jitendraphand/robot-hydraulic/electronics/generated/power_harness.md

# Power budget, harness and CAN load

Generated by `python -m hx gen`.

## Rails

| rail | V | nominal A | peak A | regulator | rating A | margin |
|---|---|---|---|---|---|---|
| LOGIC_5V | 5.0 | 1.16 | 2.05 | buck_5v_6a | 6 | 2.93 |
| BRAIN_5V | 5.1 | 1.80 | 3.50 | buck_5v_6a_pi | 6 | 1.71 |
| VALVE_6V | 6.0 | 1.12 | 6.30 | buck_6v_15a | 15 | 2.38 |
| SERVO_7V4 | 7.4 | 1.40 | 21.50 | buck_7v4_30a | 30 | 1.40 |
| PUMP_BAT | 22.2 | 10.25 | 26.25 | battery | - | nan |

Battery: nominal 263 W, peak 828 W (42 A of 200 A rated); estimated runtime at nominal load **41 min** (80 % depth of discharge).

## Harness

| id | from | to | AWG | length m | connector | fuse A | design A |
|---|---|---|---|---|---|---|---|
| W01 | BATTERY | MAIN_FUSE | 8 | 0.15 | XT90 | - | 40 |
| W02 | MAIN_FUSE | ESTOP_CONTACTOR | 8 | 0.2 | ring M5 | 60 | 40 |
| W03 | ESTOP_CONTACTOR | PDB_ACT | 8 | 0.15 | ring M5 | - | 40 |
| W04 | MAIN_FUSE | PDB_LOGIC | 16 | 0.2 | XT30 | 10 | 4 |
| W05 | PDB_ACT | ESC | 12 | 0.3 | XT60 | 35 | 26 |
| W06 | PDB_ACT | buck_7v4_30a | 14 | 0.15 | XT30 | 15 | 8 |
| W07 | PDB_LOGIC | buck_6v_15a | 16 | 0.15 | XT30 | 7.5 | 3 |
| W08 | PDB_LOGIC | buck_5v_6a | 18 | 0.15 | XT30 | 3 | 1 |
| W09 | PDB_LOGIC | buck_5v_6a_pi | 18 | 0.15 | XT30 | 3 | 1.2 |
| W10 | buck_7v4_30a | LEG_SERVO_L | 16 | 0.6 | XT30 | 10 | 4 |
| W11 | buck_7v4_30a | LEG_SERVO_R | 16 | 0.6 | XT30 | 10 | 4 |
| W12 | buck_7v4_30a | ARM_SERVO_L | 18 | 0.5 | XT30 | 7.5 | 5.5 |
| W13 | buck_7v4_30a | ARM_SERVO_R | 18 | 0.5 | XT30 | 7.5 | 5.5 |
| W14 | buck_6v_15a | LIMB_VALVE_L_LEG | 18 | 0.6 | JST-VH 2p | 5 | 2.4 |
| W15 | buck_6v_15a | LIMB_VALVE_R_LEG | 18 | 0.6 | JST-VH 2p | 5 | 2.4 |
| W16 | buck_6v_15a | LIMB_VALVE_ARMS | 18 | 0.5 | JST-VH 2p | 5 | 1.9 |
| W17 | buck_5v_6a | NODES_5V | 20 | 1.2 | JST-XH 4p (CAN+5V) | 3 | 1.6 |
| W18 | PDB_ACT | DUMP_VALVE | 22 | 0.3 | JST-XH 2p | 1 | 0.25 |
| W19 | ESTOP_BUTTON | CONTACTOR_COIL | 22 | 0.6 | JST-XH 2p | 0.5 | 0.15 |
| W20 | NODE | ENCODER | 26 | 0.6 | JST-GH 6p (shielded) | - | 0.02 |
| W21 | NODE | PRESSURE_SENSOR | 26 | 0.6 | JST-GH 3p | - | 0.01 |
| W22 | NODE | VALVE_SERVO | 22 | 0.5 | Futaba 3p | - | 0.9 |

## CAN bus load

| bus | frames/s | load |
|---|---|---|
| CAN_A | 2540 | 34.3 % |
| CAN_B | 2780 | 37.5 % |

## ERC findings

- none

## Power / harness findings

- none
