jitendraphand/robot-hydraulic/docs/img/sil_ankle_pitch.png

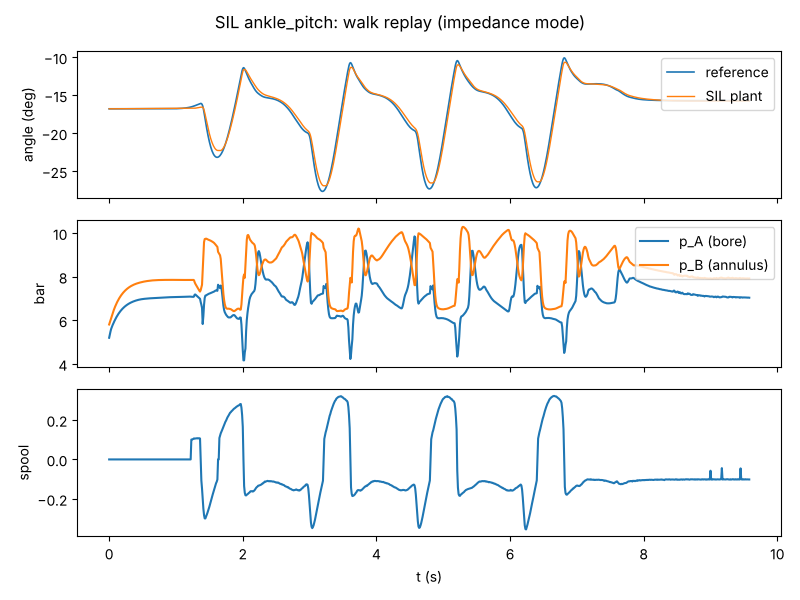
docs/img/sil_ankle_pitch.png
