jitendraphand/robot-hydraulic/docs/img/sil_ankle_roll.png

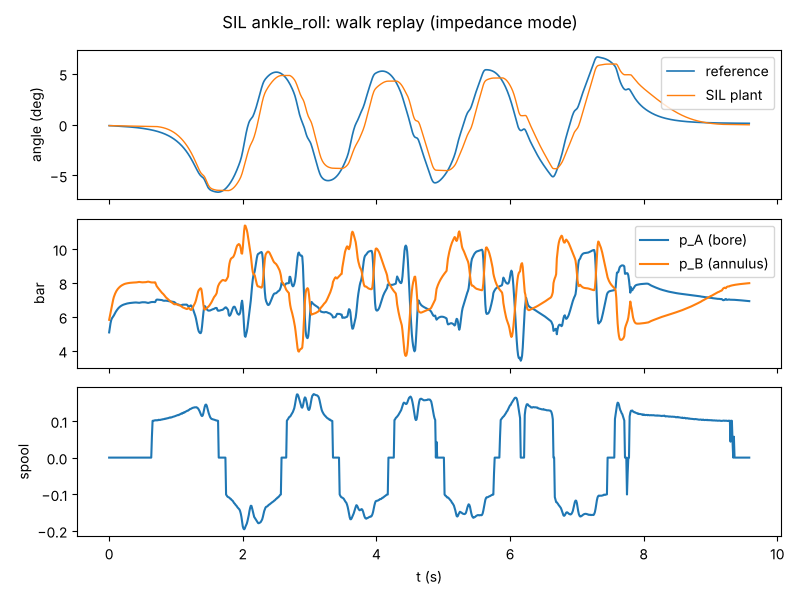
docs/img/sil_ankle_roll.png
