jitendraphand/robot-hydraulic/docs/img/sil_elbow.png

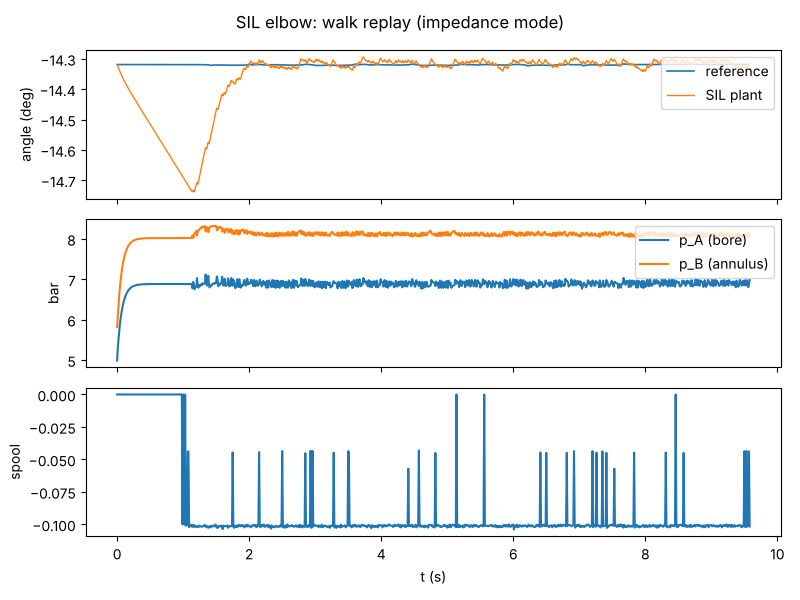
docs/img/sil_elbow.png
