jitendraphand/robot-hydraulic/docs/img/sil_hip_pitch.png

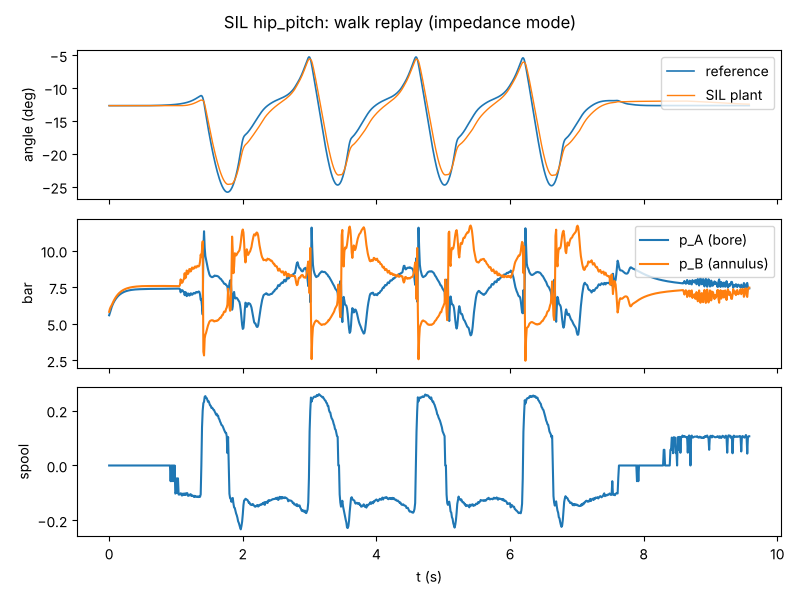
docs/img/sil_hip_pitch.png
