jitendraphand/robot-hydraulic/docs/img/sil_hip_roll.png

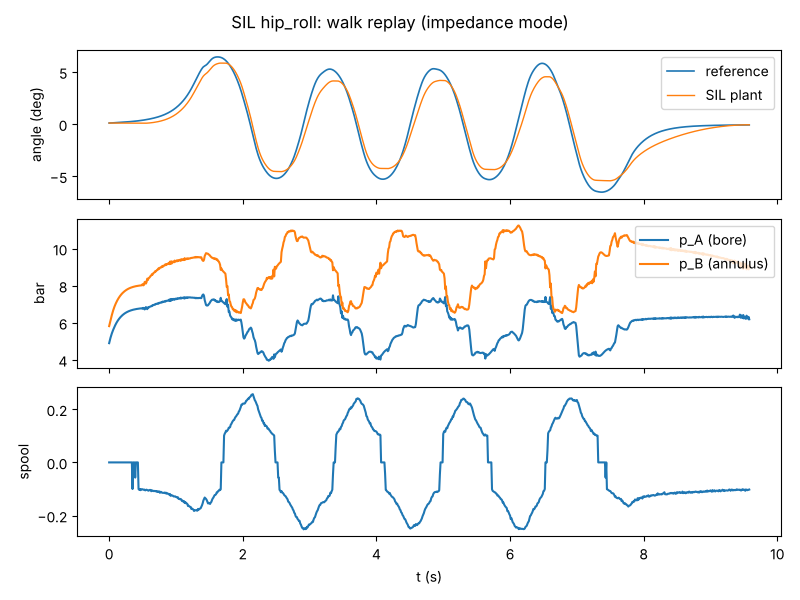
docs/img/sil_hip_roll.png
