jitendraphand/robot-hydraulic/docs/img/sil_shoulder_pitch.png

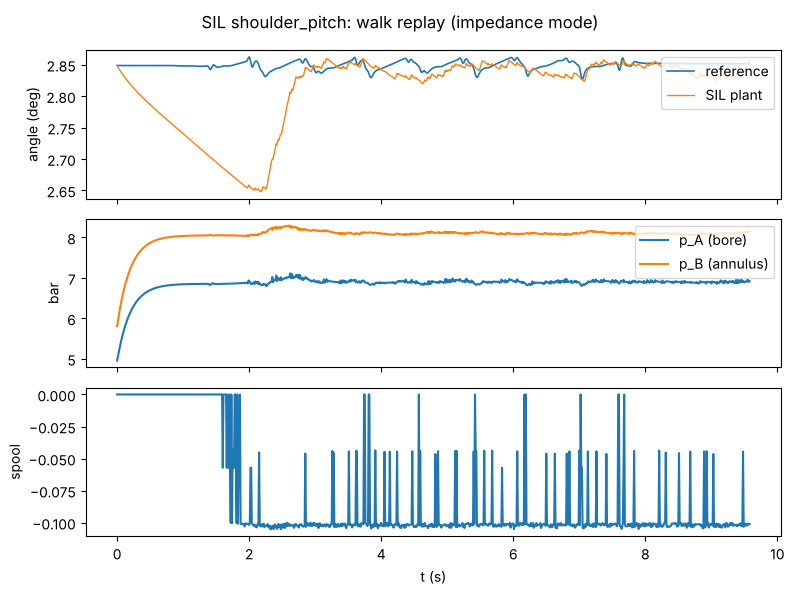
docs/img/sil_shoulder_pitch.png
