jitendraphand/robot-hydraulic/docs/video/gif/stand.gif

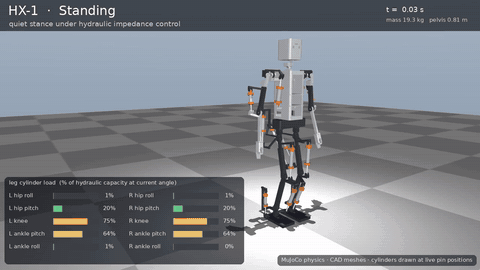
docs/video/gif/stand.gif
