jitendraphand/robot-hydraulic/cad/plates/PETG_plate03.stl

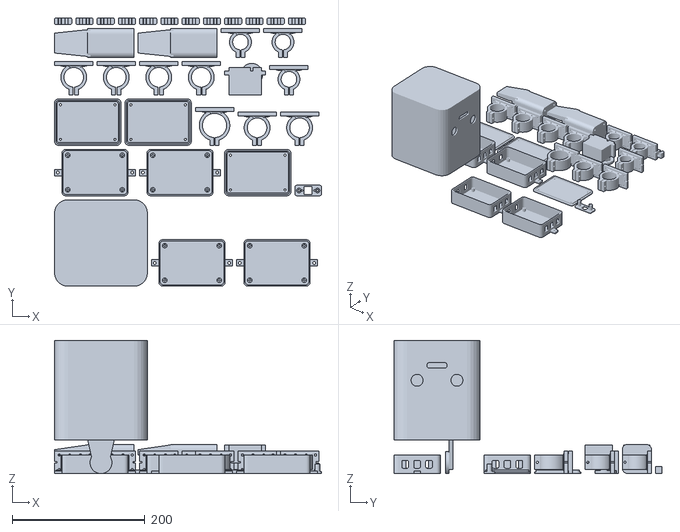
[picture p18: CAD file, 2026-11-11]
cad/plates/PETG_plate03.stl
402.0 x 404.0 x 200.5
