jitendraphand/robot-hydraulic/cad/stl/L_ankle_link.stl

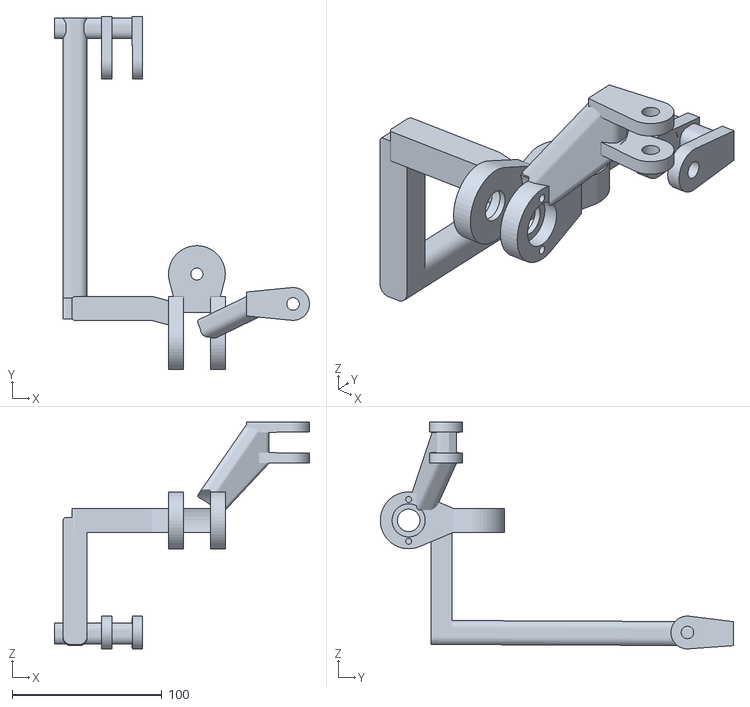
[picture p19: CAD file, 2026-11-11]
cad/stl/L_ankle_link.stl
170.6 x 236.4 x 151.7
