jitendraphand/robot-hydraulic/cad/plates/PA12-CF_plate04.stl

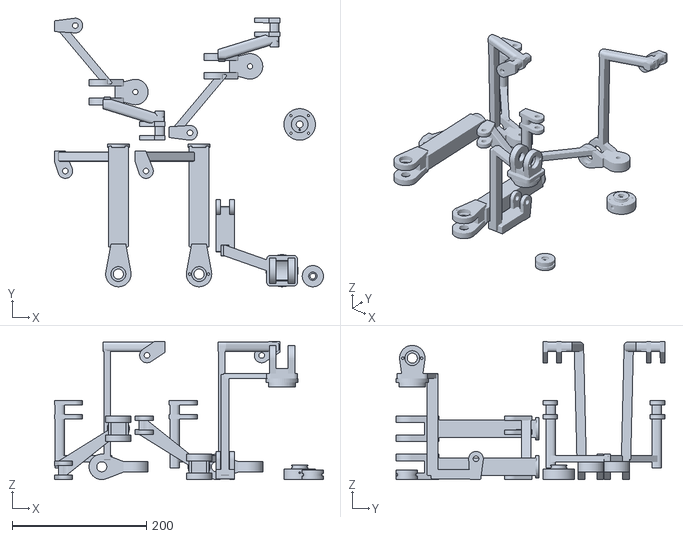
[picture p20: CAD file, 2026-11-11]
cad/plates/PA12-CF_plate04.stl
400.8 x 400.3 x 205.8
