jitendraphand/robot-hydraulic/cad/stl/R_shin.stl

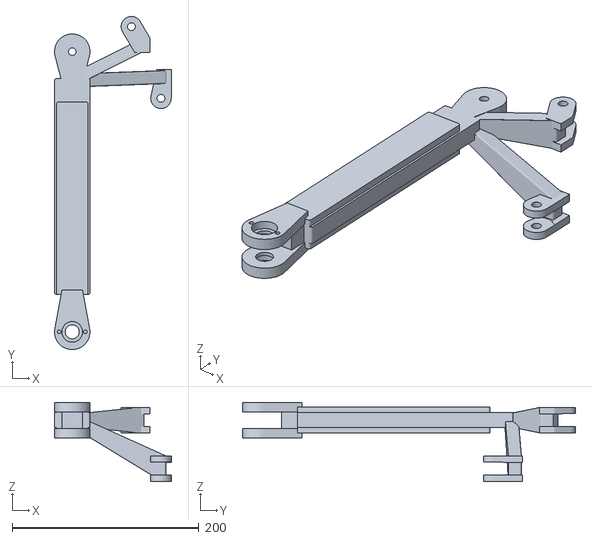
[picture p21: CAD file, 2026-11-11]
cad/stl/R_shin.stl
125.3 x 356.7 x 84.8
