jitendraphand/robot-hydraulic/cad/plates/PA12-CF_plate01.stl

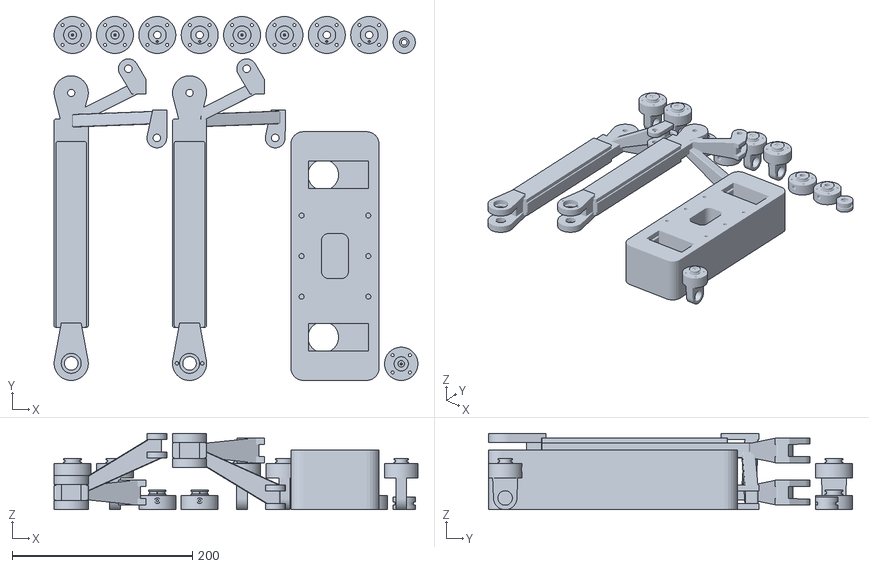
[picture p22: CAD file, 2026-11-11]
cad/plates/PA12-CF_plate01.stl
403.5 x 403.7 x 84.8
