jitendraphand/robot-hydraulic/cad/stl/R_hip_roll_link.stl

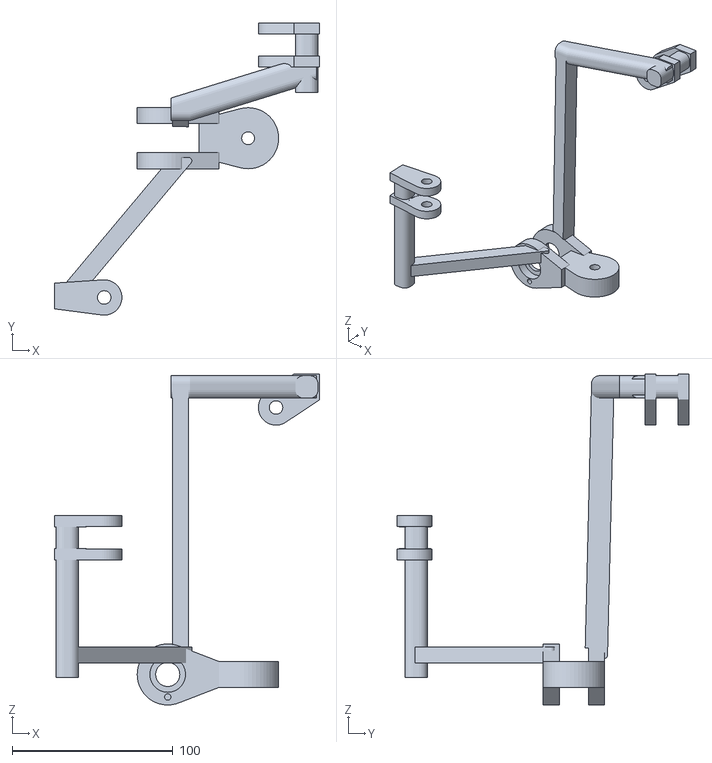
[picture p23: CAD file, 2026-11-11]
cad/stl/R_hip_roll_link.stl
164.9 x 181.8 x 205.8
