jitendraphand/robot-hydraulic/cad/plates/PA12-CF_plate05.stl

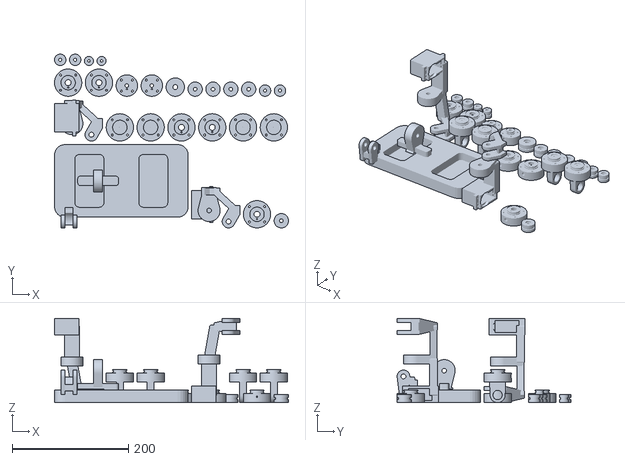
[picture p24: CAD file, 2026-11-11]
cad/plates/PA12-CF_plate05.stl
402.7 x 299.2 x 144.9
