jitendraphand/robot-hydraulic/cad/stl/L_hip_yaw_link.stl

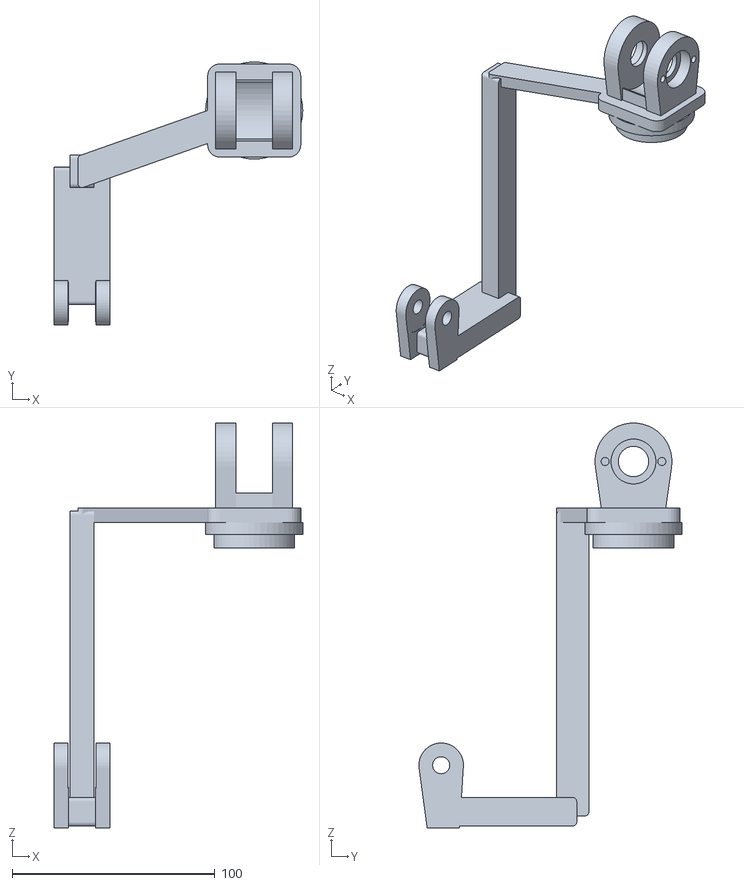
[picture p25: CAD file, 2026-11-11]
cad/stl/L_hip_yaw_link.stl
122.8 x 129.9 x 199.9
