jitendraphand/robot-hydraulic/cad/plates/PA12-CF_plate02.stl

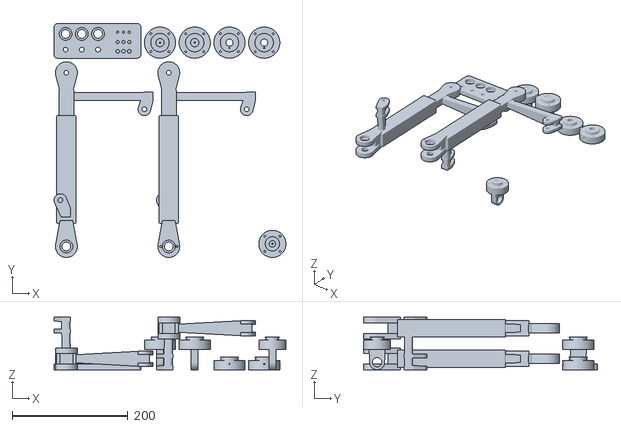
[picture p26: CAD file, 2026-11-11]
cad/plates/PA12-CF_plate02.stl
400.6 x 404.0 x 90.8
