jitendraphand/robot-hydraulic/cad/stl/R_upper_arm.stl

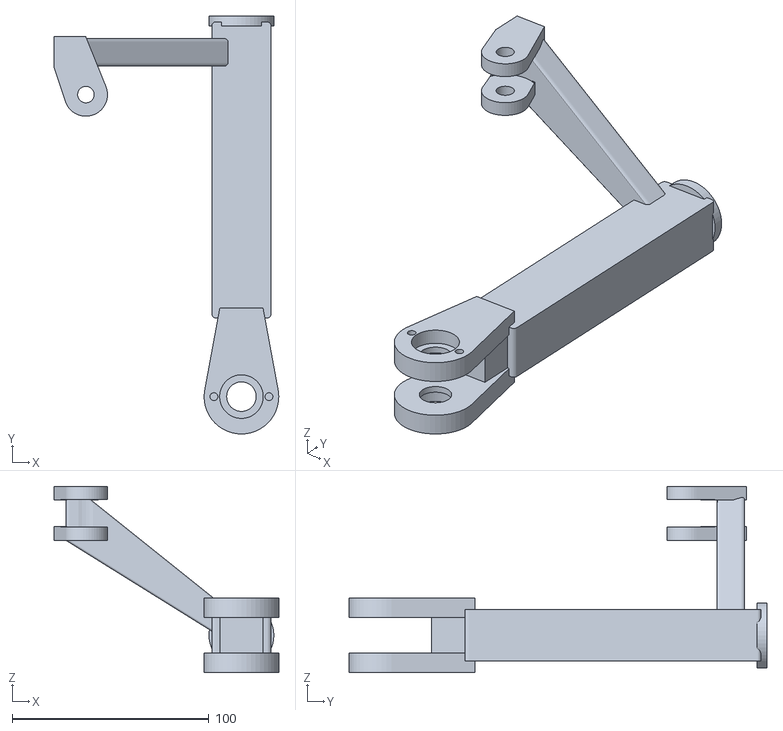
[picture p27: CAD file, 2026-11-11]
cad/stl/R_upper_arm.stl
114.2 x 212.5 x 94.8
