jitendraphand/robot-hydraulic/cad/plates/PA12-CF_plate03.stl

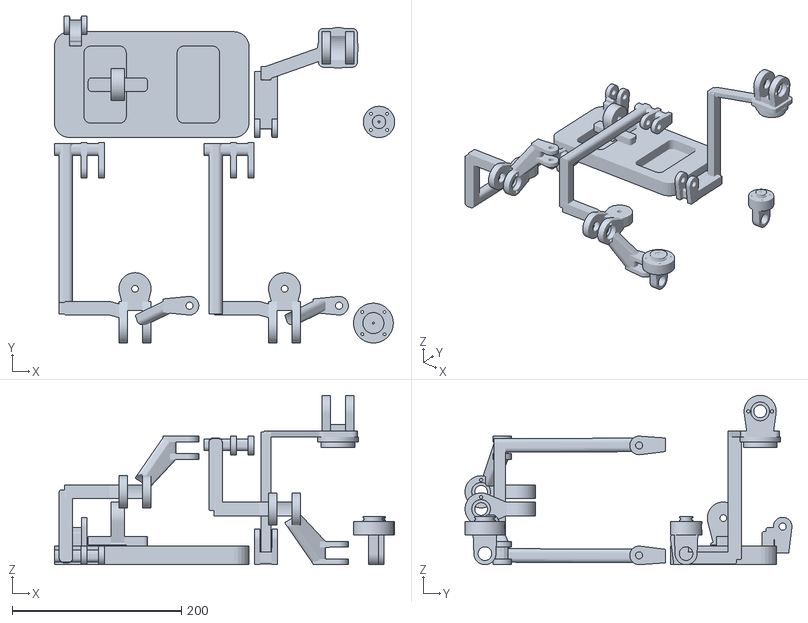
[picture p28: CAD file, 2026-11-11]
cad/plates/PA12-CF_plate03.stl
401.8 x 385.9 x 199.9
