jitendraphand/robot-hydraulic/cad/plates/PETG_plate01.stl

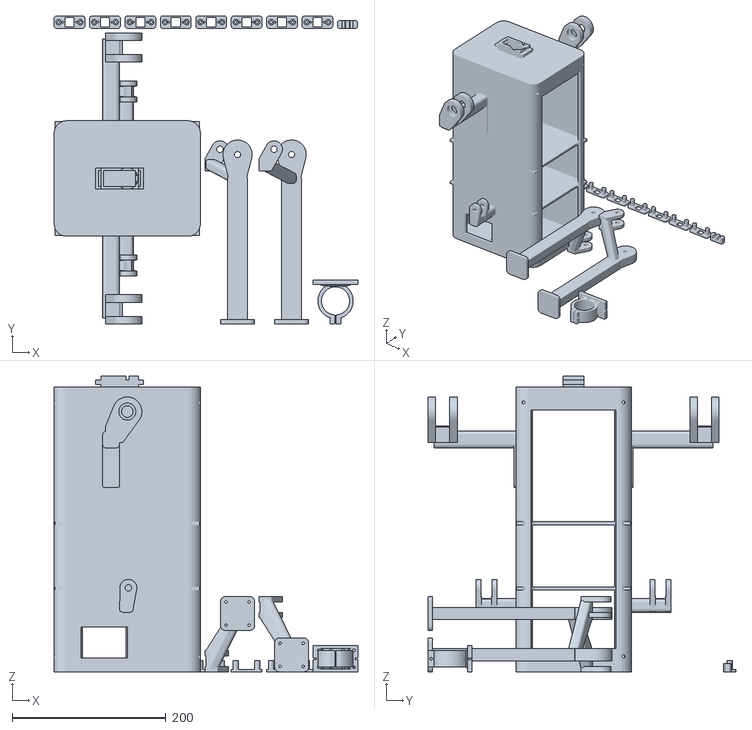
[picture p29: CAD file, 2026-11-11]
cad/plates/PETG_plate01.stl
394.5 x 400.0 x 384.0
