jitendraphand/robot-hydraulic/cad/plates/PETG_plate02.stl

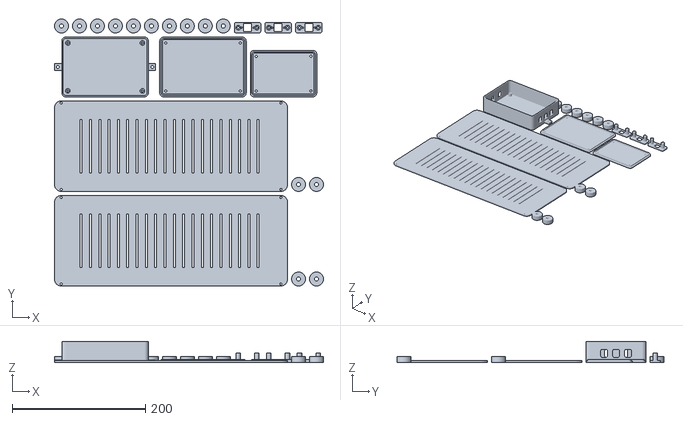
[picture p30: CAD file, 2026-11-11]
cad/plates/PETG_plate02.stl
404.0 x 401.0 x 32.0
