jitendraphand/robot-hydraulic/cad/stl/L_thigh.stl

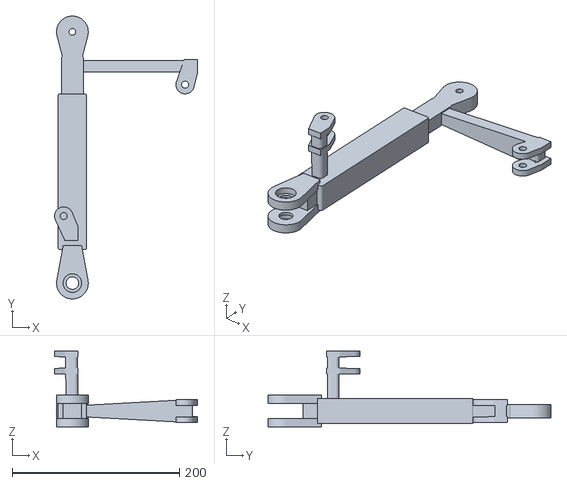
[picture p31: CAD file, 2026-11-11]
cad/stl/L_thigh.stl
170.8 x 338.0 x 90.8
