jitendraphand/robot-hydraulic/cad/plates/PETG_plate04.stl

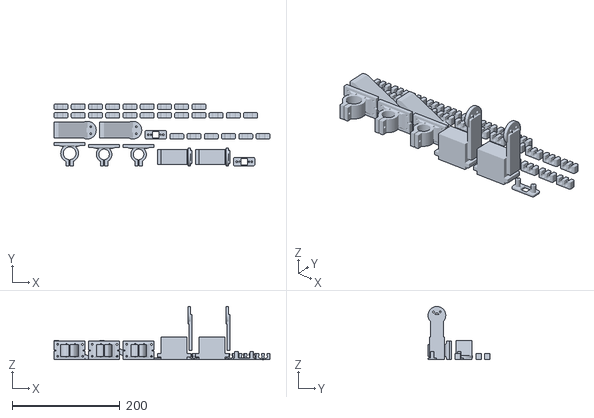
[picture p32: CAD file, 2026-11-11]
cad/plates/PETG_plate04.stl
401.0 x 115.0 x 98.5
