jitendraphand/robot-hydraulic/cad/plates/TPU95A_plate01.stl

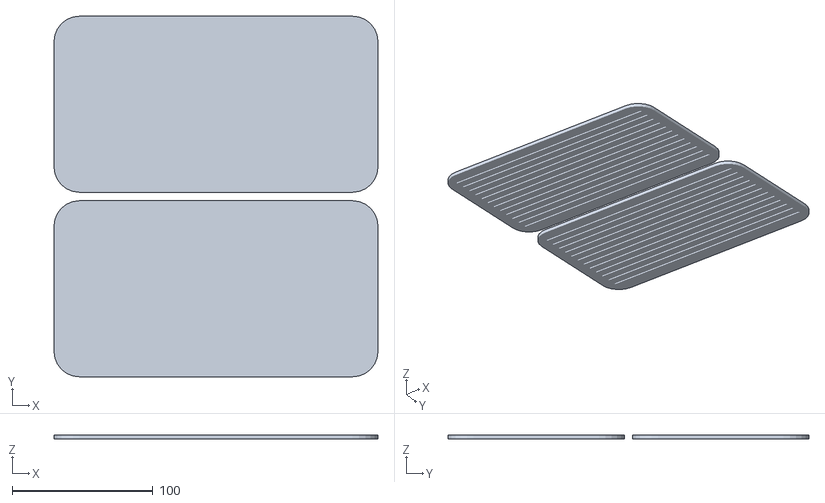
[picture p33: CAD file, 2026-11-11]
cad/plates/TPU95A_plate01.stl
230.0 x 256.0 x 3.00
