jitendraphand/robot-hydraulic/cad/stl/R_forearm.stl

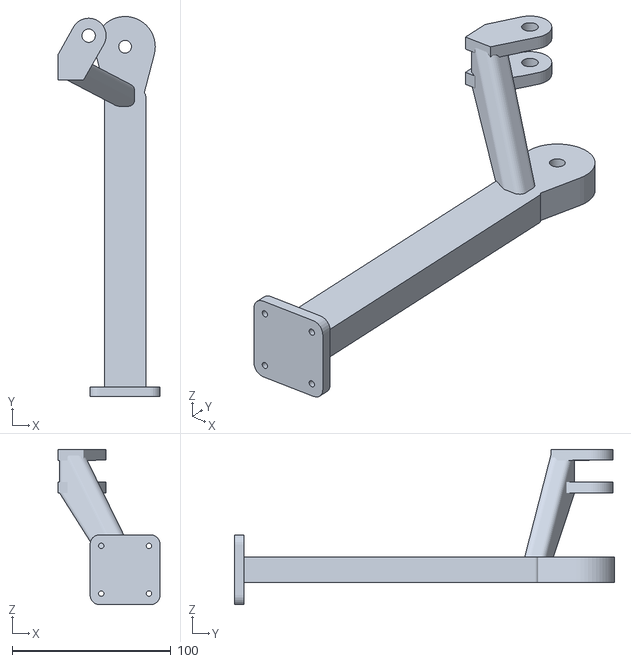
[picture p34: CAD file, 2026-11-11]
cad/stl/R_forearm.stl
64.2 x 239.0 x 97.8
