jitendraphand/robot-hydraulic/cad/stl/R_foot.stl

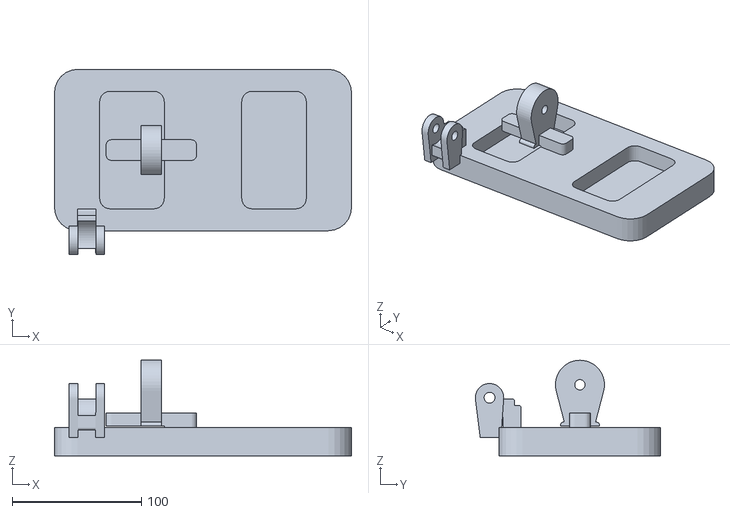
[picture p35: CAD file, 2026-11-11]
cad/stl/R_foot.stl
230.0 x 143.5 x 74.0
