jitendraphand/robot-hydraulic/cad/stl/L_shoulder_link.stl

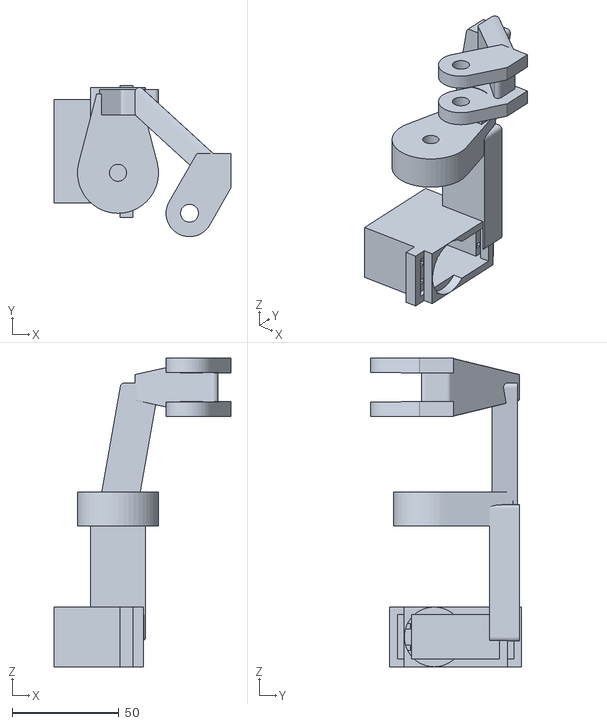
[picture p36: CAD file, 2026-11-11]
cad/stl/L_shoulder_link.stl
83.0 x 71.0 x 144.9
