jitendraphand/robot-hydraulic/cad/stl/cyl_b32s75_rod_cap.stl

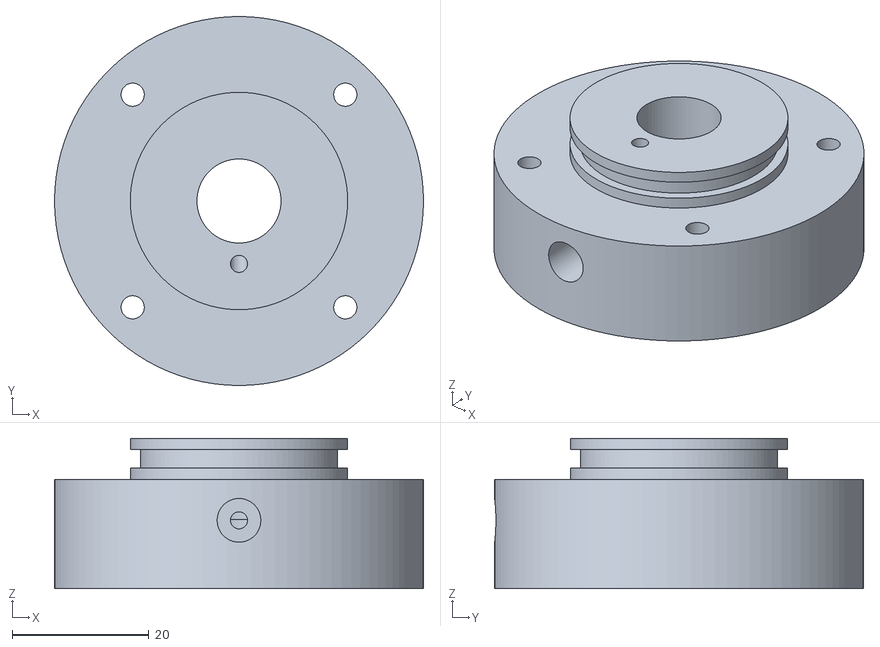
[picture p37: CAD file, 2026-11-11]
cad/stl/cyl_b32s75_rod_cap.stl
54.0 x 54.0 x 22.0
