jitendraphand/robot-hydraulic/cad/stl/foot_pad.stl

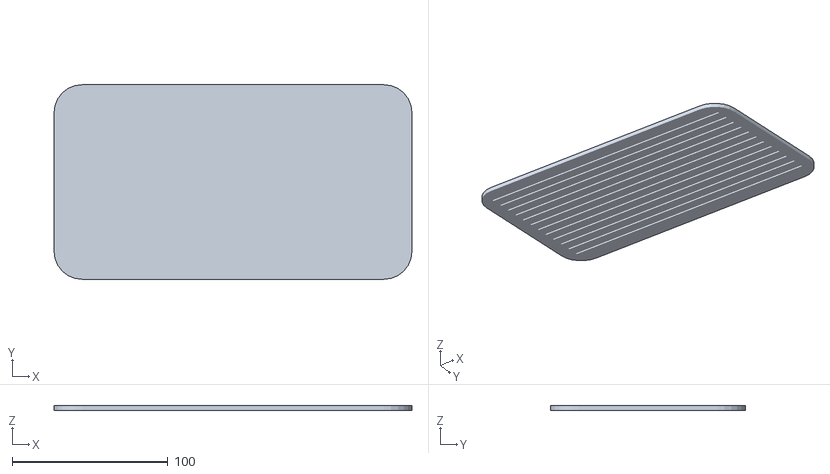
[picture p38: CAD file, 2026-11-11]
cad/stl/foot_pad.stl
230.0 x 125.0 x 3.00
