jitendraphand/robot-hydraulic/cad/stl/cyl_b32s75_blind_cap.stl

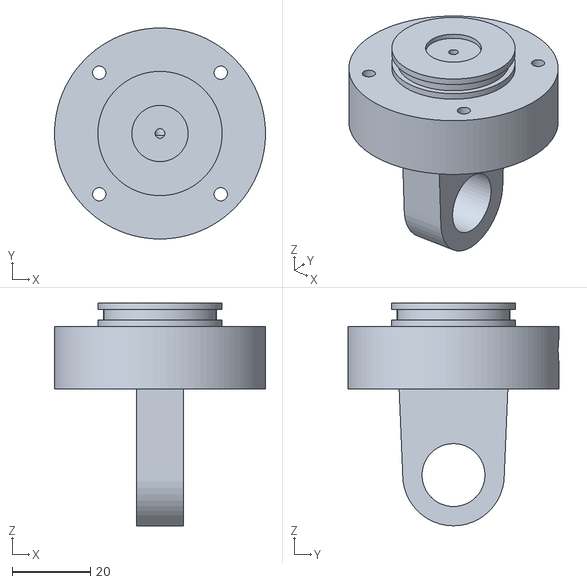
[picture p39: CAD file, 2026-11-11]
cad/stl/cyl_b32s75_blind_cap.stl
54.0 x 54.0 x 57.0
