jitendraphand/robot-hydraulic/cad/stl/cyl_b16s140_blind_cap.stl

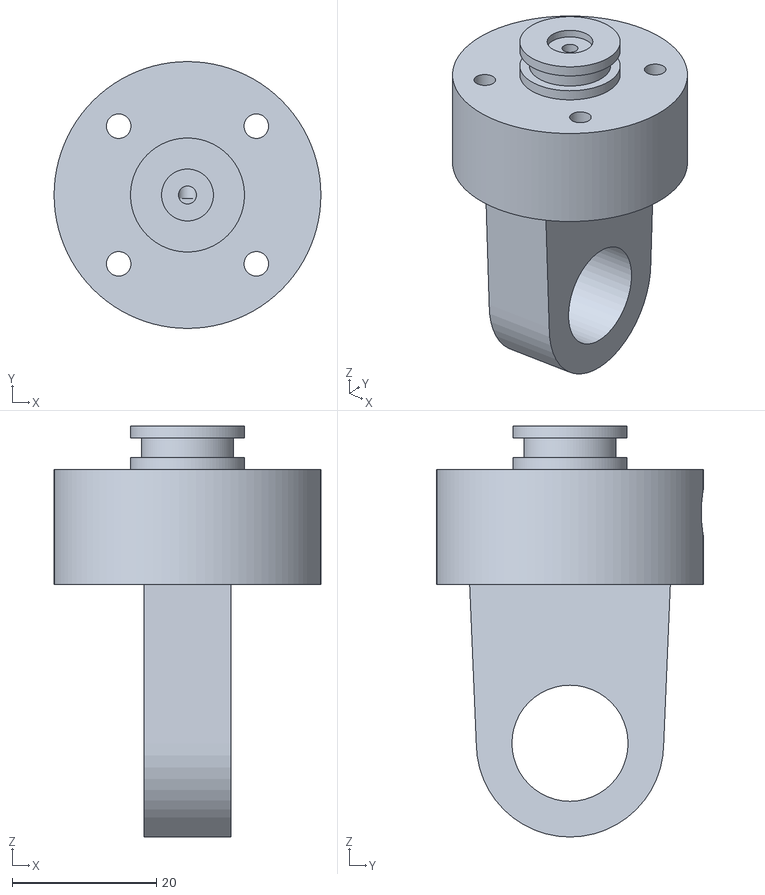
[picture p40: CAD file, 2026-11-11]
cad/stl/cyl_b16s140_blind_cap.stl
37.0 x 37.0 x 57.0
