jitendraphand/robot-hydraulic/cad/stl/cyl_b20s55_piston.stl

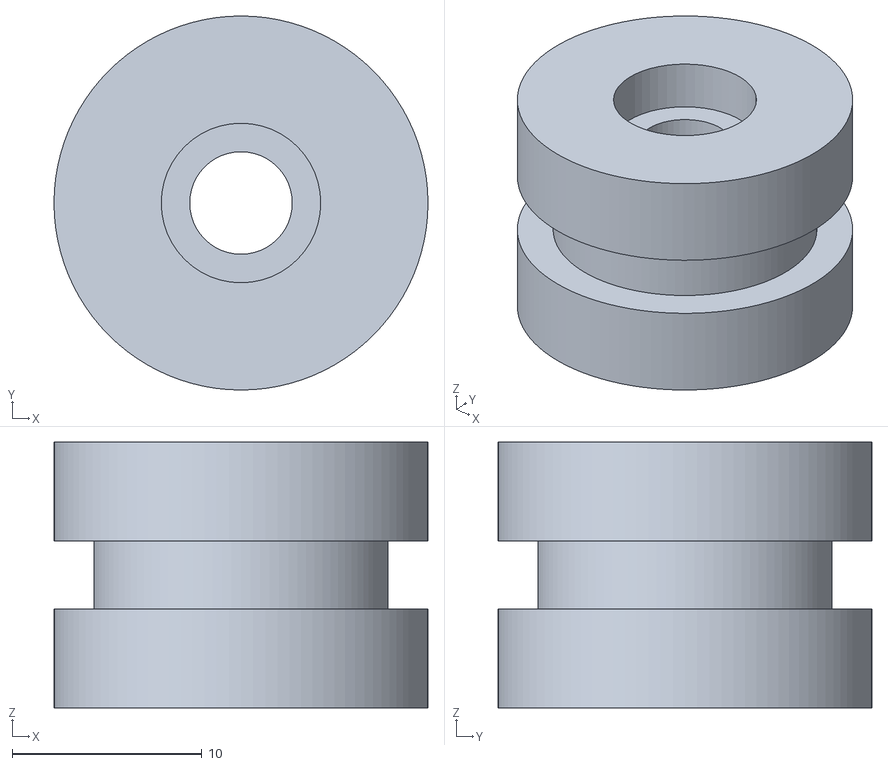
[picture p41: CAD file, 2026-11-11]
cad/stl/cyl_b20s55_piston.stl
19.7 x 19.7 x 14.0
