jitendraphand/robot-hydraulic/cad/stl/R_finger.stl

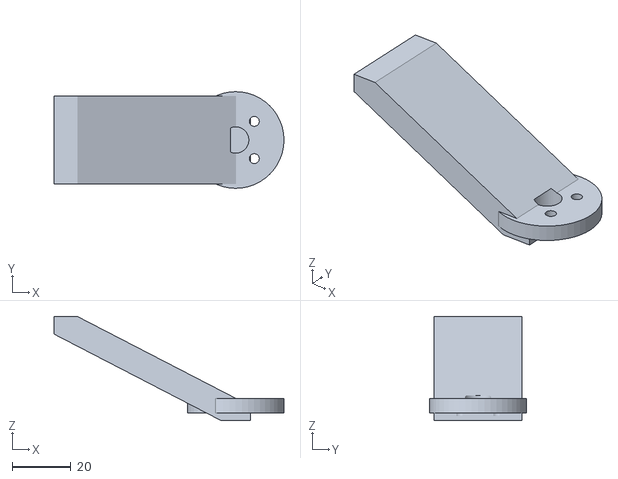
[picture p42: CAD file, 2026-11-11]
cad/stl/R_finger.stl
78.5 x 33.0 x 35.5
