jitendraphand/robot-hydraulic/cad/stl/cyl_b20s55_valve_saddle.stl

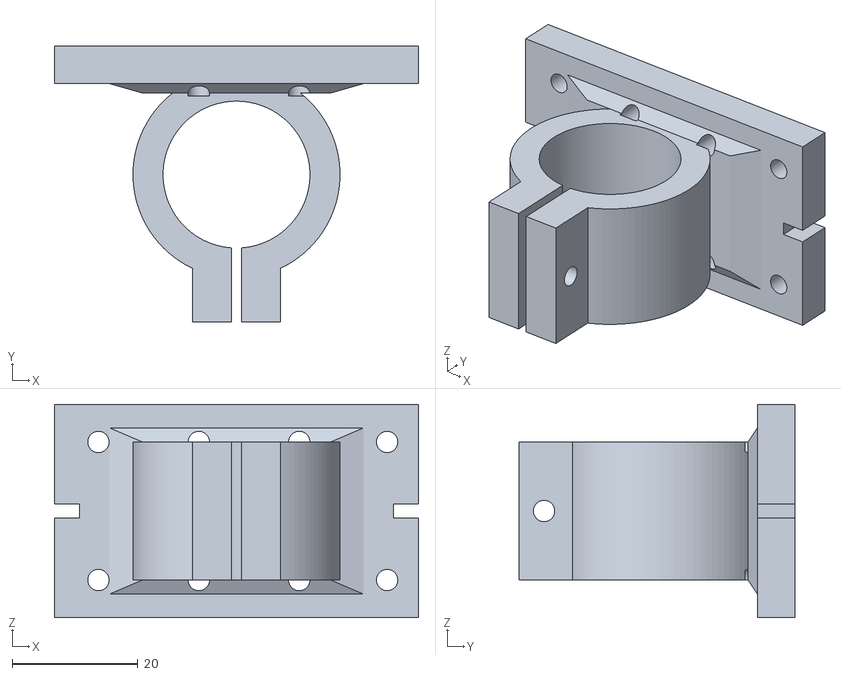
[picture p43: CAD file, 2026-11-11]
cad/stl/cyl_b20s55_valve_saddle.stl
58.0 x 44.0 x 34.0
