jitendraphand/robot-hydraulic/cad/stl/cyl_b32s75_valve_saddle.stl

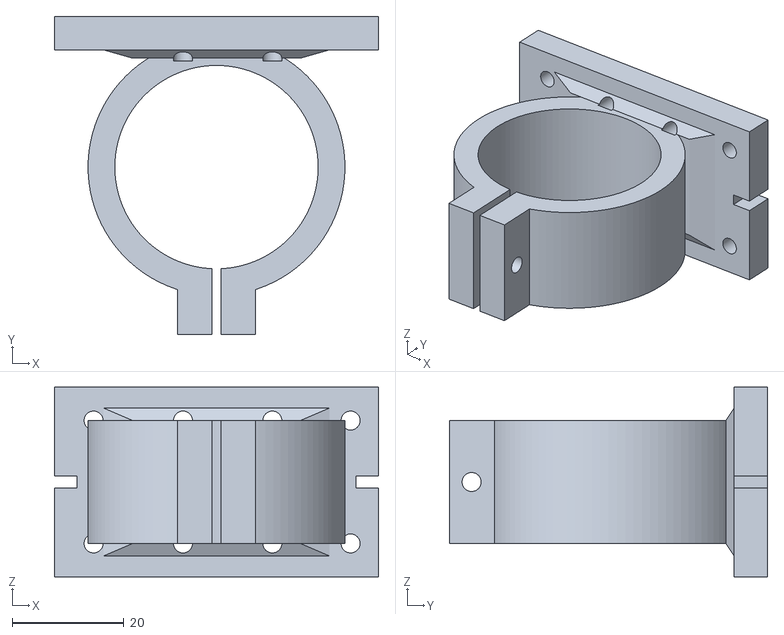
[picture p44: CAD file, 2026-11-11]
cad/stl/cyl_b32s75_valve_saddle.stl
58.0 x 57.0 x 34.0
