jitendraphand/robot-hydraulic/cad/stl/cyl_b25s100_blind_cap.stl

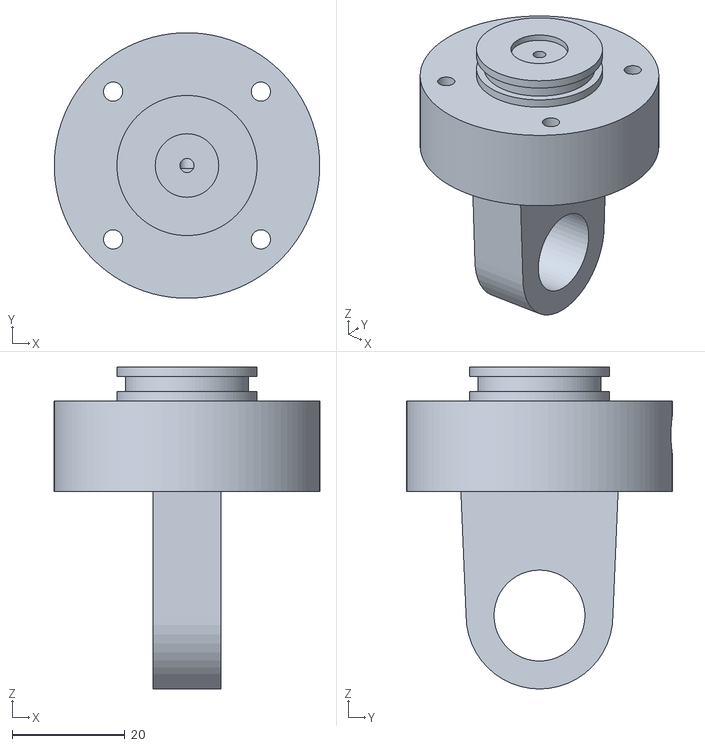
[picture p45: CAD file, 2026-11-11]
cad/stl/cyl_b25s100_blind_cap.stl
47.0 x 47.0 x 57.0
