jitendraphand/robot-hydraulic/cad/stl/R_upper_arm_roll.stl

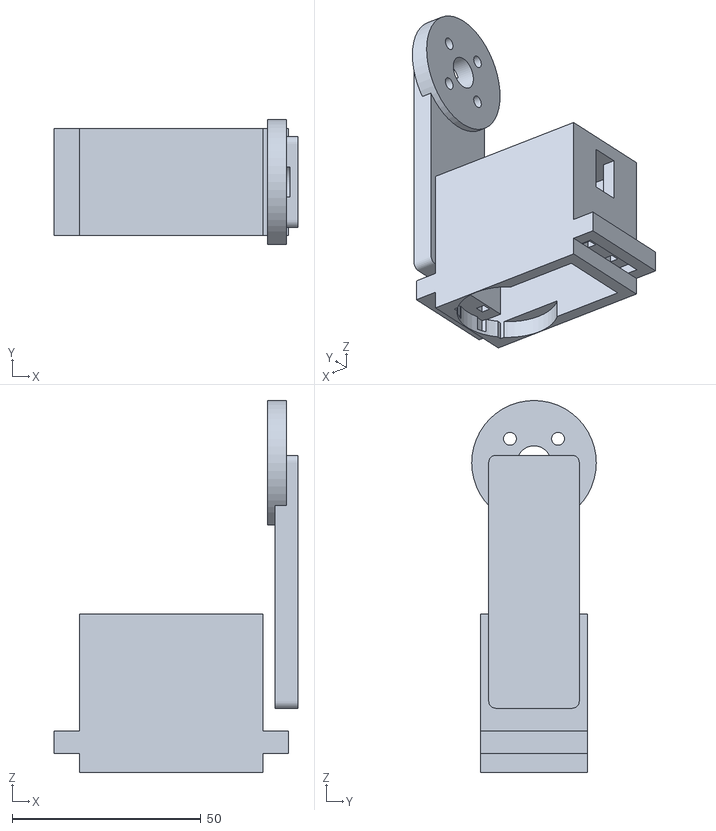
[picture p46: CAD file, 2026-11-11]
cad/stl/R_upper_arm_roll.stl
64.5 x 33.0 x 98.5
