jitendraphand/robot-hydraulic/cad/stl/cyl_b32s75_piston.stl

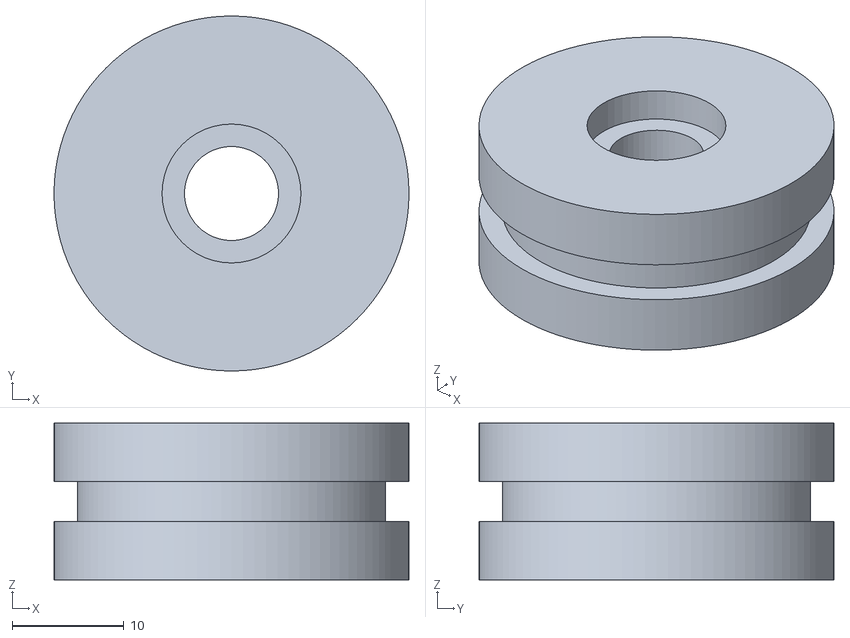
[picture p47: CAD file, 2026-11-11]
cad/stl/cyl_b32s75_piston.stl
31.7 x 31.7 x 14.0
