jitendraphand/robot-hydraulic/cad/stl/hub_lid.stl

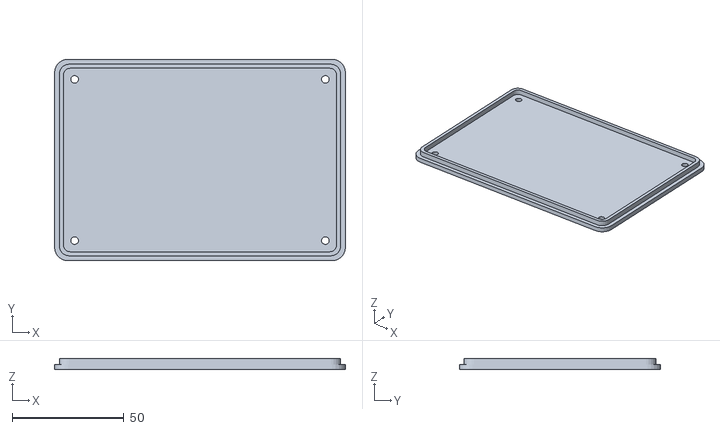
[picture p48: CAD file, 2026-11-11]
cad/stl/hub_lid.stl
130.0 x 90.0 x 5.10
