jitendraphand/robot-hydraulic/cad/stl/cyl_b25s100_piston.stl

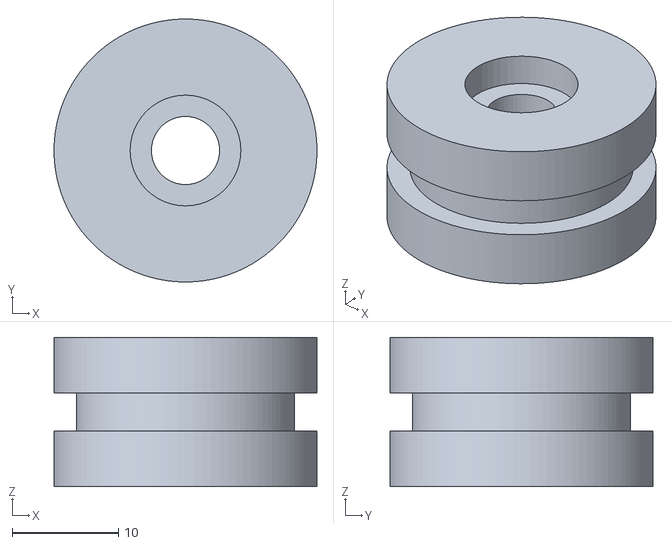
[picture p49: CAD file, 2026-11-11]
cad/stl/cyl_b25s100_piston.stl
24.7 x 24.7 x 14.0
