jitendraphand/robot-hydraulic/cad/stl/cyl_b20s55_rod_cap.stl

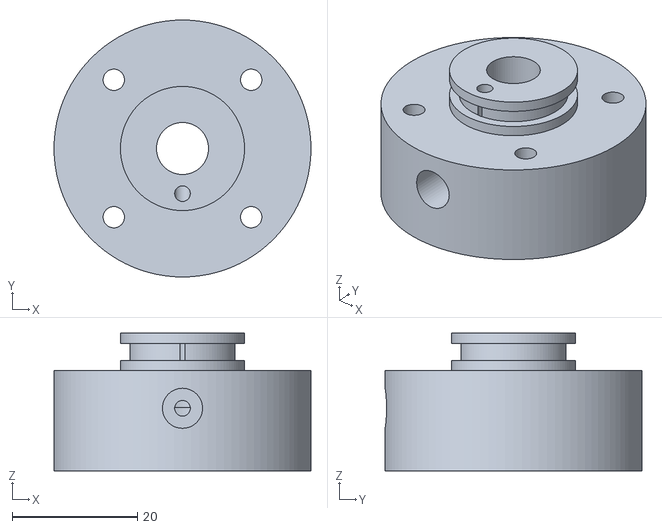
[picture p50: CAD file, 2026-11-11]
cad/stl/cyl_b20s55_rod_cap.stl
41.0 x 41.0 x 22.0
