jitendraphand/robot-hydraulic/cad/stl/limb_node_lid.stl

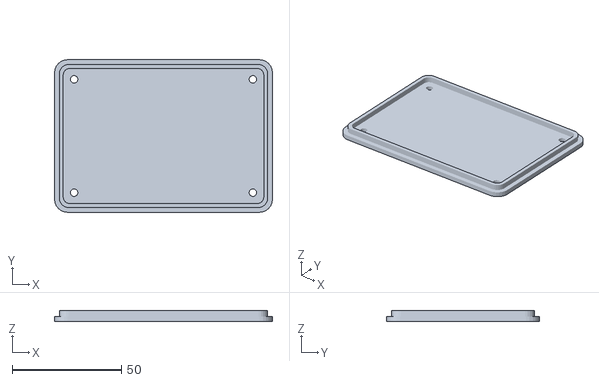
[picture p51: CAD file, 2026-11-11]
cad/stl/limb_node_lid.stl
100.0 x 70.0 x 5.10
