jitendraphand/robot-hydraulic/cad/stl/hose_clip.stl

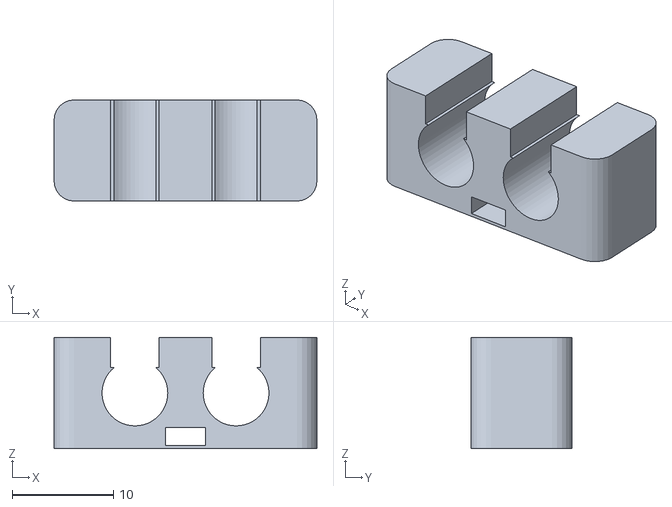
[picture p52: CAD file, 2026-11-11]
cad/stl/hose_clip.stl
26.0 x 10.0 x 11.0
