jitendraphand/robot-hydraulic/cad/stl/cyl_b16s140_piston.stl

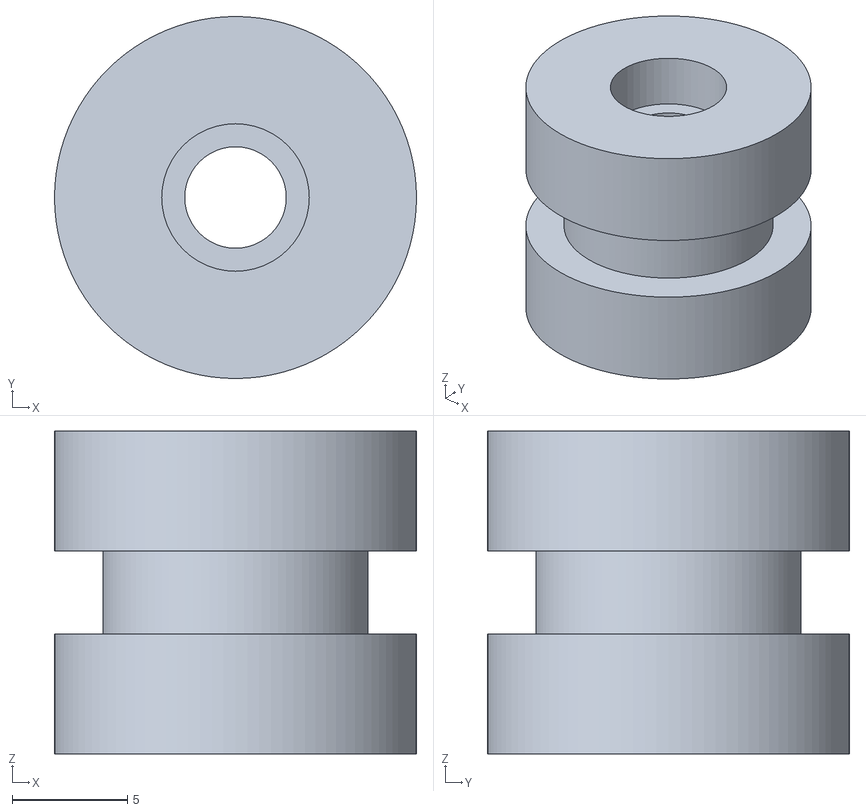
[picture p53: CAD file, 2026-11-11]
cad/stl/cyl_b16s140_piston.stl
15.7 x 15.7 x 14.0
