jitendraphand/robot-hydraulic/cad/stl/encoder_magnet_cap.stl

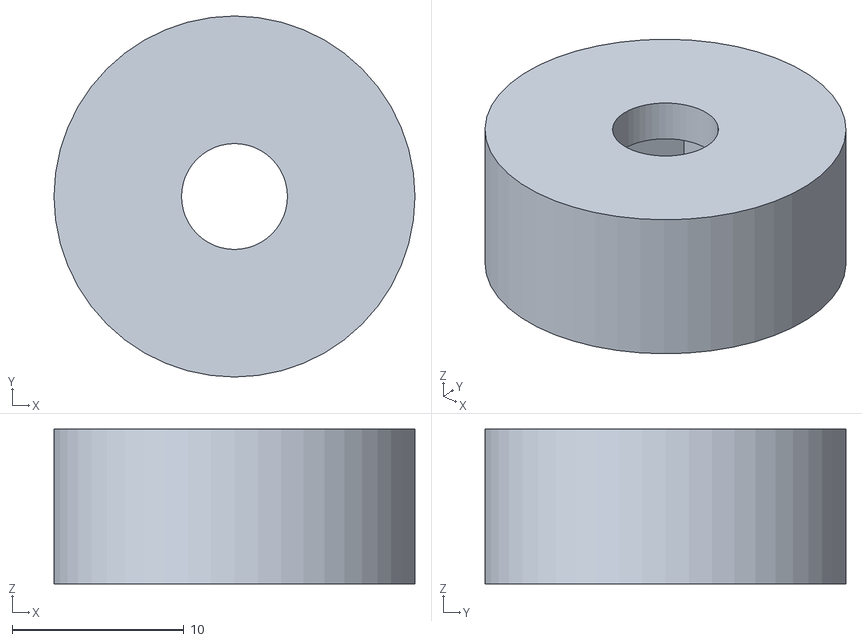
[picture p54: CAD file, 2026-11-11]
cad/stl/encoder_magnet_cap.stl
21.0 x 21.0 x 9.00
