jitendraphand/robot-hydraulic/cad/stl/head.stl

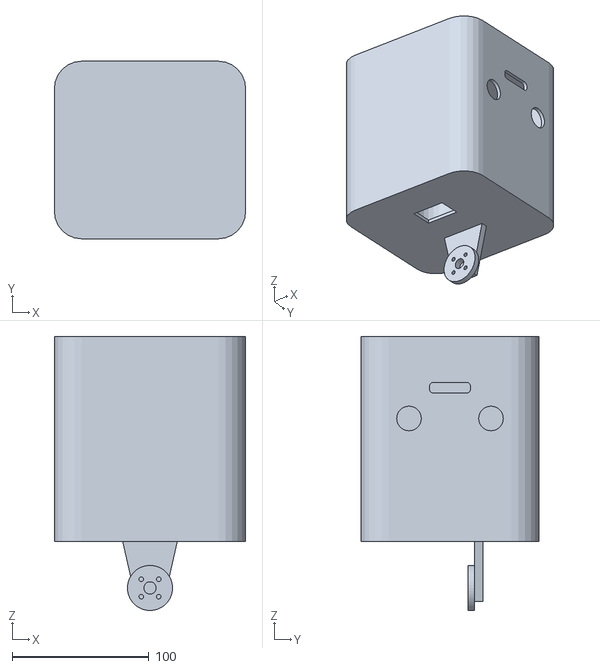
[picture p55: CAD file, 2026-11-11]
cad/stl/head.stl
140.0 x 130.0 x 200.5
