jitendraphand/robot-hydraulic/cad/stl/torso.stl

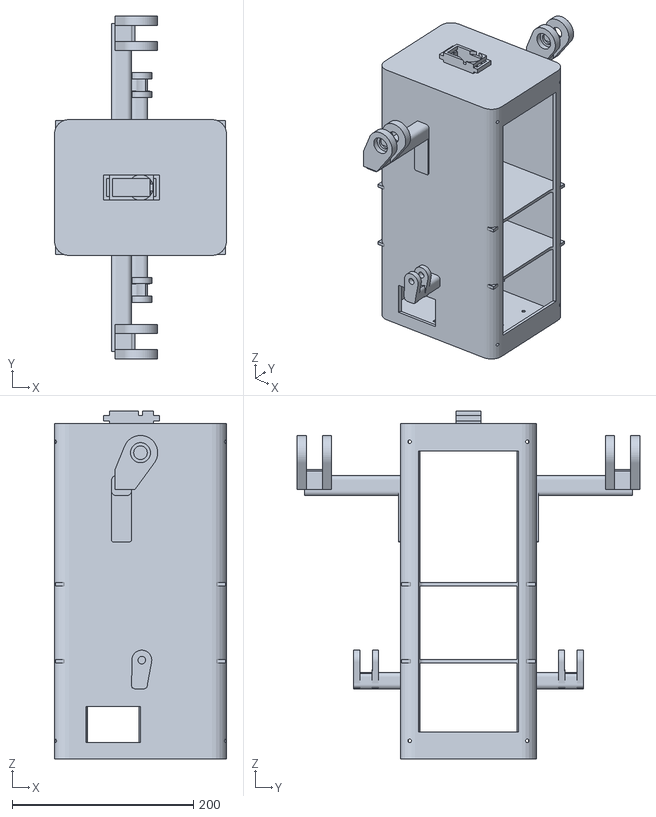
[picture p56: CAD file, 2026-11-11]
cad/stl/torso.stl
190.0 x 378.0 x 384.0
