jitendraphand/robot-hydraulic/cad/stl/cyl_b25s105_rod_cap.stl

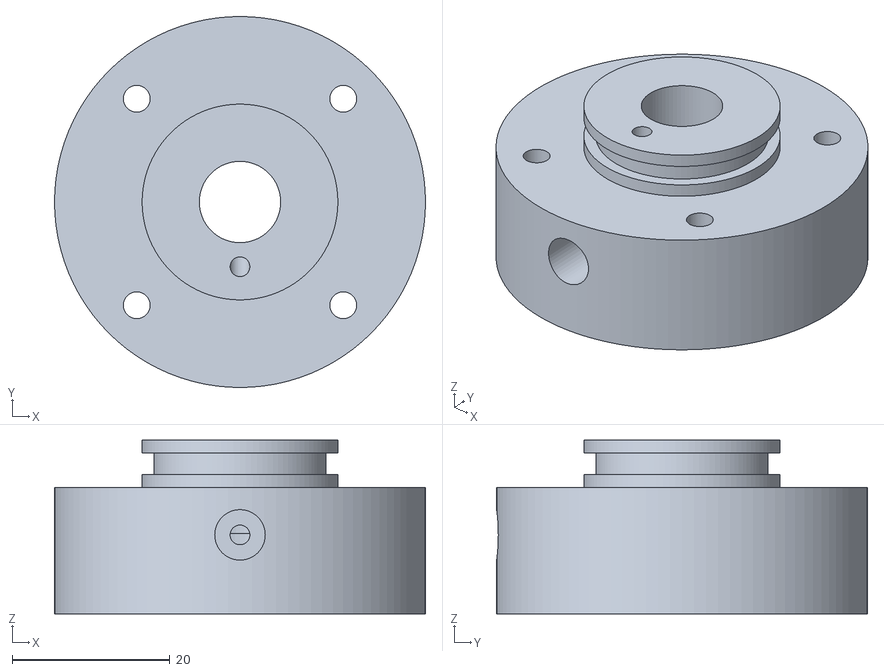
[picture p57: CAD file, 2026-11-11]
cad/stl/cyl_b25s105_rod_cap.stl
47.0 x 47.0 x 22.0
