jitendraphand/robot-hydraulic/cad/stl/cyl_b20s40_blind_cap.stl

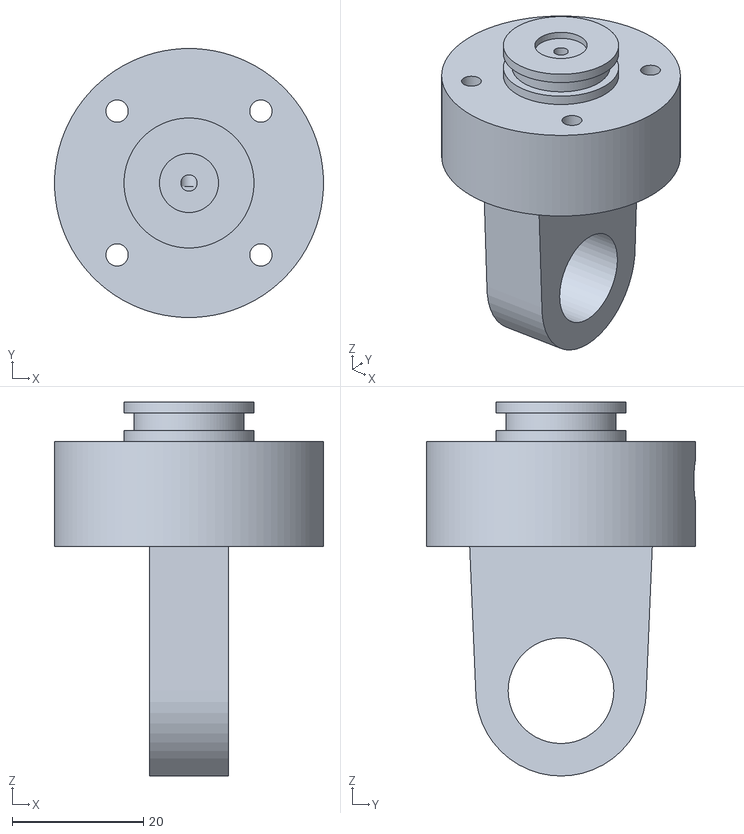
[picture p58: CAD file, 2026-11-11]
cad/stl/cyl_b20s40_blind_cap.stl
41.0 x 41.0 x 57.0
