jitendraphand/robot-hydraulic/cad/stl/encoder_bracket.stl

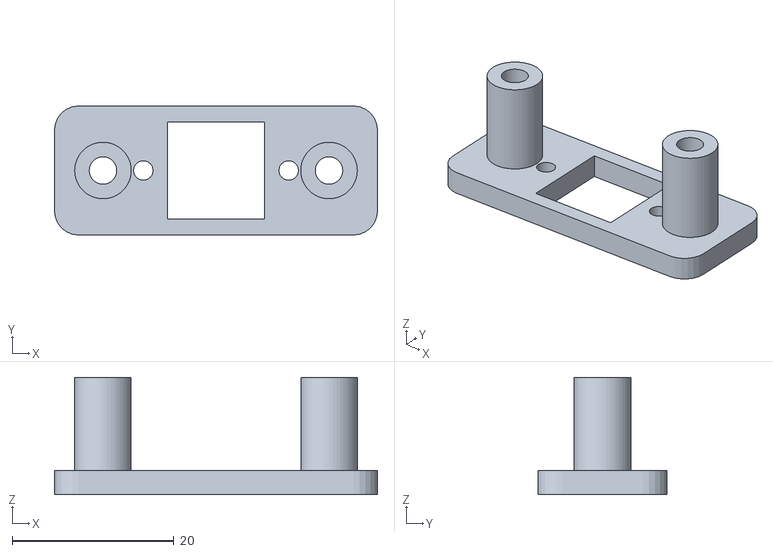
[picture p59: CAD file, 2026-11-11]
cad/stl/encoder_bracket.stl
40.0 x 16.0 x 14.5
