jitendraphand/robot-hydraulic/cad/stl/fit_coupon.stl

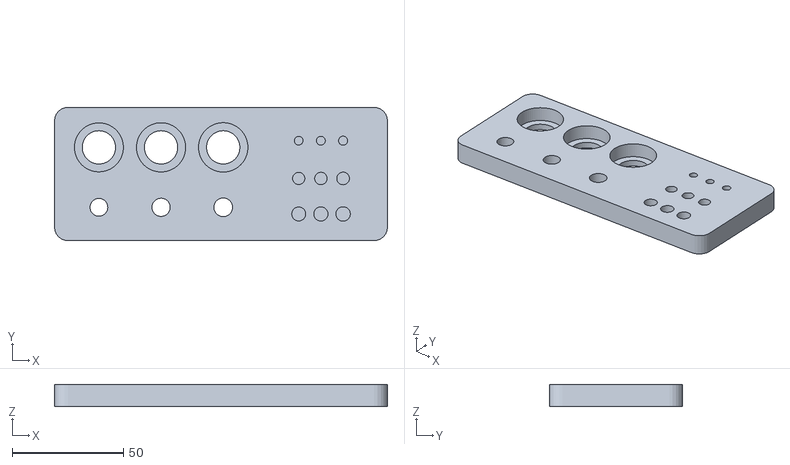
[picture p60: CAD file, 2026-11-11]
cad/stl/fit_coupon.stl
150.0 x 60.0 x 10.0
