jitendraphand/robot-hydraulic/cad/stl/neck_link.stl

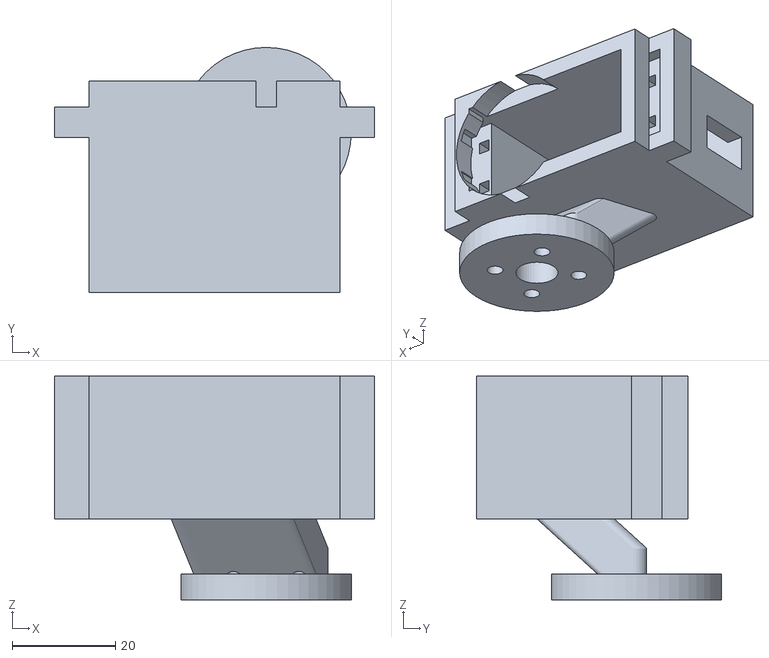
[picture p61: CAD file, 2026-11-11]
cad/stl/neck_link.stl
62.0 x 47.5 x 43.3
