jitendraphand/robot-hydraulic/cad/stl/torso_cover.stl

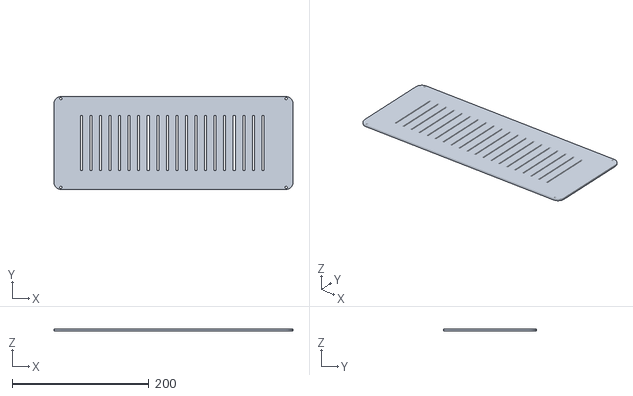
[picture p62: CAD file, 2026-11-11]
cad/stl/torso_cover.stl
350.0 x 136.0 x 3.00
