jitendraphand/robot-hydraulic/cad/stl/R_hand.stl

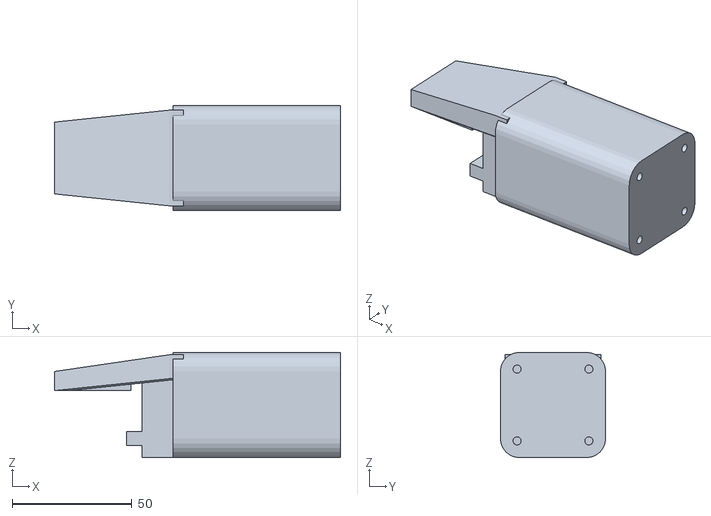
[picture p63: CAD file, 2026-11-11]
cad/stl/R_hand.stl
119.5 x 44.0 x 44.0
