jitendraphand/robot-hydraulic/cad/stl/cyl_b16s140_valve_saddle.stl

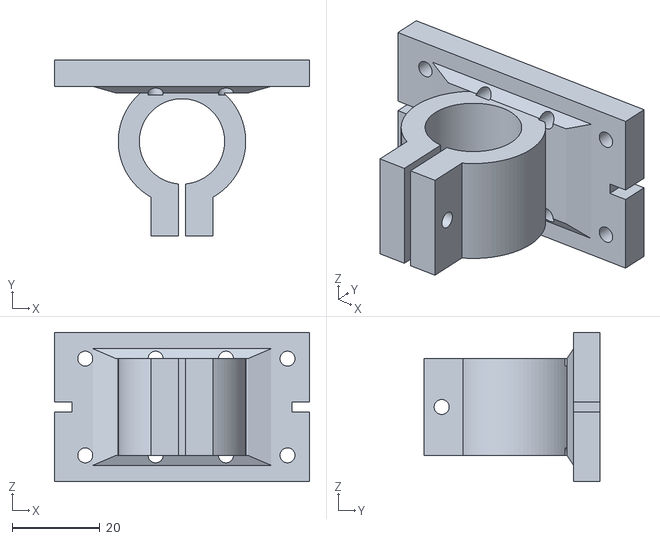
[picture p64: CAD file, 2026-11-11]
cad/stl/cyl_b16s140_valve_saddle.stl
58.0 x 40.0 x 34.0
