jitendraphand/robot-hydraulic/cad/stl/cyl_b25s100_valve_saddle.stl

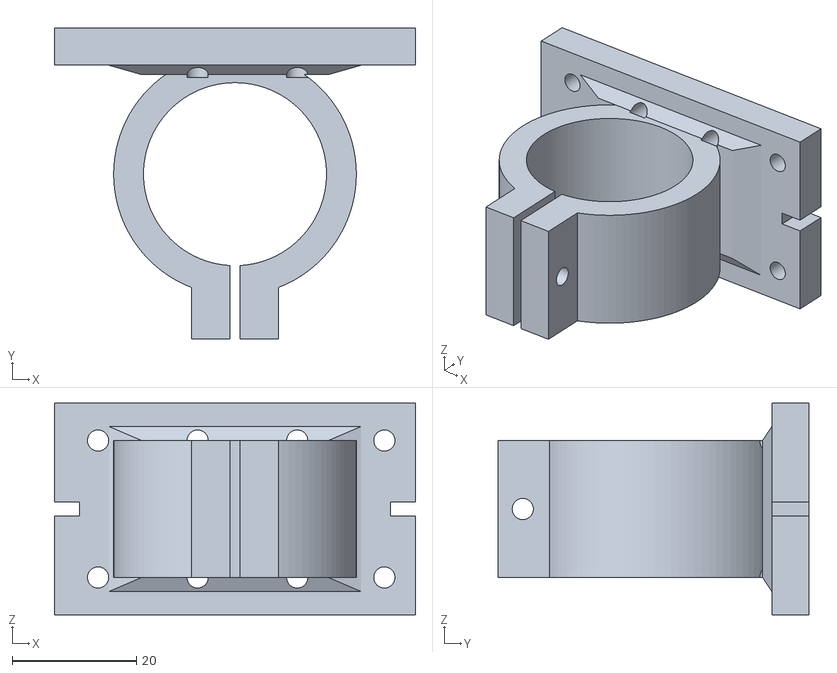
[picture p65: CAD file, 2026-11-11]
cad/stl/cyl_b25s100_valve_saddle.stl
58.0 x 50.0 x 34.0
