jitendraphand/robot-hydraulic/cad/stl/limb_node_enclosure.stl

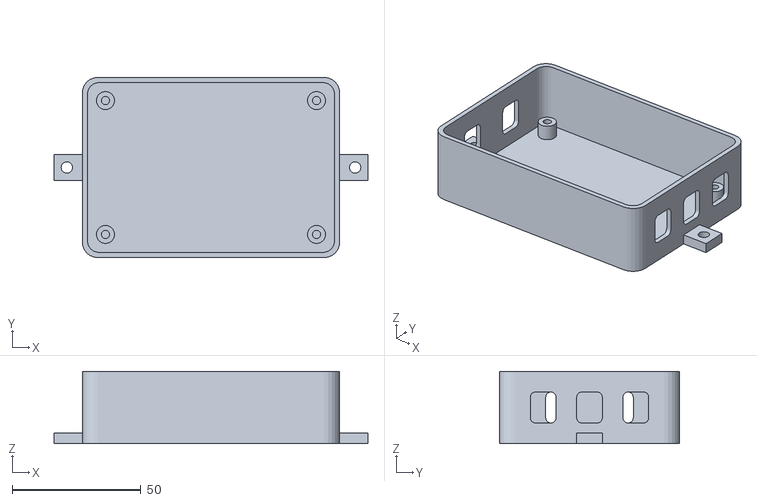
[picture p66: CAD file, 2026-11-11]
cad/stl/limb_node_enclosure.stl
122.0 x 70.0 x 28.0
