jitendraphand/robot-hydraulic/cad/stl/pelvis.stl

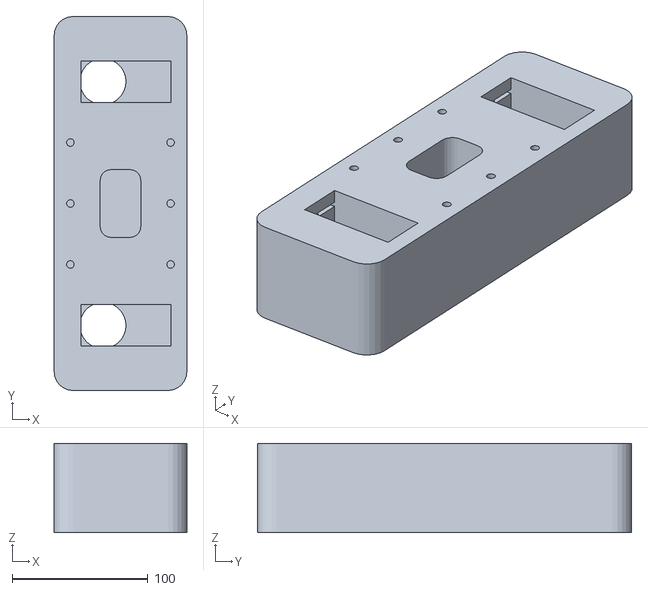
[picture p67: CAD file, 2026-11-11]
cad/stl/pelvis.stl
98.0 x 276.0 x 66.0
