jitendraphand/robot-hydraulic/cad/stl/cyl_b16s140_rod_cap.stl

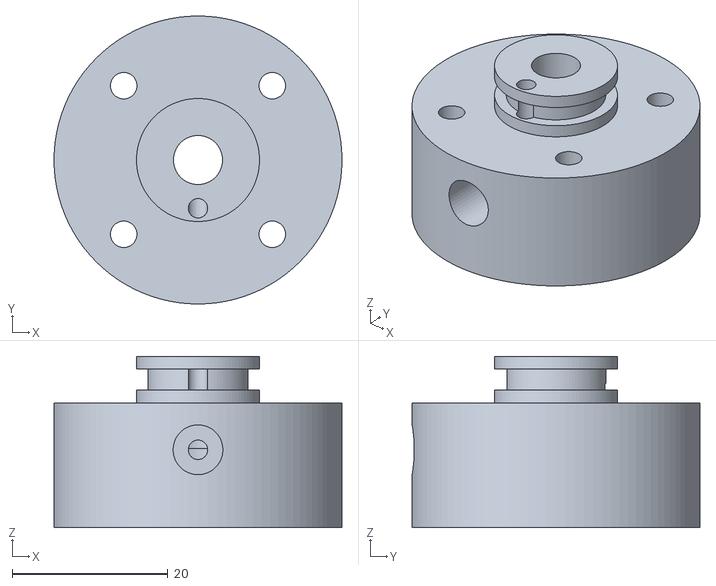
[picture p68: CAD file, 2026-11-11]
cad/stl/cyl_b16s140_rod_cap.stl
37.0 x 37.0 x 22.0
