jitendraphand/robot-hydraulic/cad/stl/hub_enclosure.stl

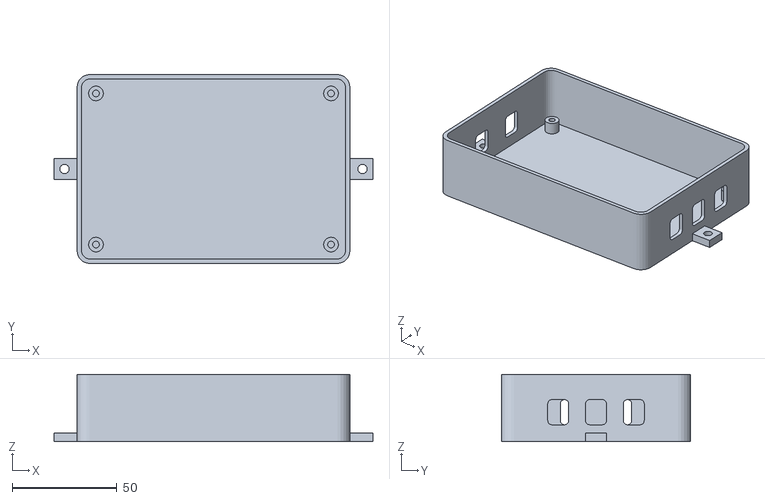
[picture p69: CAD file, 2026-11-11]
cad/stl/hub_enclosure.stl
152.0 x 90.0 x 32.0
