jitendraphand/robot-hydraulic/(list of files, cad)

Other CAD files:
cad/stl/L_shin.stl
cad/stl/L_hip_roll_link.stl
cad/stl/R_ankle_link.stl
cad/stl/R_hip_yaw_link.stl
cad/stl/L_upper_arm.stl
cad/stl/R_thigh.stl
cad/stl/L_forearm.stl
cad/stl/L_foot.stl
cad/stl/L_upper_arm_roll.stl
cad/stl/L_finger.stl
cad/stl/R_shoulder_link.stl
cad/stl/L_hand.stl
