jitendraphand/robot-hydraulic/cad/print_plan.md

# Print plan — Elegoo Neptune 4 Max (420 x 420 x 480 mm)

Generated by `python -m hx cad`. Do not edit by hand.

## Profiles

| profile | layer | perimeters | top/bottom | infill |
|---|---|---|---|---|
| structural | 0.2 mm | 5 | 6 | 35 % gyroid |
| pressure | 0.16 mm | 8 | 10 | 100 % rectilinear |
| standard | 0.2 mm | 3 | 4 | 20 % gyroid |
| flexible | 0.2 mm | 3 | 4 | 25 % gyroid |

## Materials

| material | nozzle | bed | hardened nozzle | note |
|---|---|---|---|---|
| PETG | 240 C | 75 C | no |  |
| PA12-CF | 280 C | 80 C | yes | Dry 8 h at 80 C before printing; print from a dry box. |
| TPU95A | 225 C | 50 C | no |  |
| PLA | 210 C | 60 C | no | Fit-check prototypes only — never for loaded or pressurised parts. |

## Parts

| part | qty | material | profile | orient (deg) | bed footprint (mm) | g each | h each | fits |
|---|---|---|---|---|---|---|---|---|
| `fit_coupon` | 1 | PA12-CF | pressure | (0, 0, 0) | 150 x 60 x 10 | 86 | 2.0 | yes |
| `torso_cover` | 2 | PETG | standard | (0, 90, 0) | 350 x 136 x 3 | 163 | 3.4 | yes |
| `hub_enclosure` | 1 | PETG | standard | (0, 0, 0) | 152 x 90 x 32 | 61 | 1.3 | yes |
| `hub_lid` | 1 | PETG | standard | (0, 0, 0) | 130 x 90 x 5 | 38 | 0.8 | yes |
| `limb_node_enclosure` | 4 | PETG | standard | (0, 0, 0) | 122 x 70 x 28 | 39 | 0.8 | yes |
| `limb_node_lid` | 4 | PETG | standard | (0, 0, 0) | 100 x 70 x 5 | 23 | 0.5 | yes |
| `cyl_b16s140_blind_cap` | 2 | PA12-CF | pressure | (0, 0, 0) | 37 x 37 x 57 | 28 | 0.7 | yes |
| `cyl_b16s140_piston` | 2 | PA12-CF | pressure | (0, 0, 0) | 16 x 16 x 14 | 2 | 0.1 | yes |
| `cyl_b16s140_rod_cap` | 2 | PA12-CF | pressure | (180, 0, 0) | 37 x 37 x 22 | 18 | 0.4 | yes |
| `cyl_b16s140_valve_saddle` | 2 | PETG | structural | (0, 0, 0) | 58 x 40 x 34 | 27 | 0.6 | yes |
| `cyl_b20s40_blind_cap` | 2 | PA12-CF | pressure | (0, 0, 0) | 41 x 41 x 57 | 33 | 0.8 | yes |
| `cyl_b20s40_piston` | 2 | PA12-CF | pressure | (0, 0, 0) | 20 x 20 x 14 | 4 | 0.1 | yes |
| `cyl_b20s40_rod_cap` | 2 | PA12-CF | pressure | (180, 0, 0) | 41 x 41 x 22 | 23 | 0.5 | yes |
| `cyl_b20s40_valve_saddle` | 2 | PETG | structural | (0, 0, 0) | 58 x 44 x 34 | 29 | 0.6 | yes |
| `cyl_b20s55_blind_cap` | 2 | PA12-CF | pressure | (0, 0, 0) | 41 x 41 x 57 | 33 | 0.8 | yes |
| `cyl_b20s55_piston` | 2 | PA12-CF | pressure | (0, 0, 0) | 20 x 20 x 14 | 4 | 0.1 | yes |
| `cyl_b20s55_rod_cap` | 2 | PA12-CF | pressure | (180, 0, 0) | 41 x 41 x 22 | 23 | 0.5 | yes |
| `cyl_b20s55_valve_saddle` | 2 | PETG | structural | (0, 0, 0) | 58 x 44 x 34 | 29 | 0.6 | yes |
| `cyl_b25s100_blind_cap` | 2 | PA12-CF | pressure | (0, 0, 0) | 47 x 47 x 57 | 42 | 1.0 | yes |
| `cyl_b25s100_piston` | 2 | PA12-CF | pressure | (0, 0, 0) | 25 x 25 x 14 | 6 | 0.1 | yes |
| `cyl_b25s100_rod_cap` | 2 | PA12-CF | pressure | (180, 0, 0) | 47 x 47 x 22 | 30 | 0.7 | yes |
| `cyl_b25s100_valve_saddle` | 2 | PETG | structural | (0, 0, 0) | 58 x 50 x 34 | 31 | 0.7 | yes |
| `cyl_b25s105_blind_cap` | 2 | PA12-CF | pressure | (0, 0, 0) | 47 x 47 x 57 | 42 | 1.0 | yes |
| `cyl_b25s105_piston` | 2 | PA12-CF | pressure | (0, 0, 0) | 25 x 25 x 14 | 6 | 0.1 | yes |
| `cyl_b25s105_rod_cap` | 2 | PA12-CF | pressure | (180, 0, 0) | 47 x 47 x 22 | 30 | 0.7 | yes |
| `cyl_b25s105_valve_saddle` | 2 | PETG | structural | (0, 0, 0) | 58 x 50 x 34 | 31 | 0.7 | yes |
| `cyl_b25s75_blind_cap` | 2 | PA12-CF | pressure | (0, 0, 0) | 47 x 47 x 57 | 42 | 1.0 | yes |
| `cyl_b25s75_piston` | 2 | PA12-CF | pressure | (0, 0, 0) | 25 x 25 x 14 | 6 | 0.1 | yes |
| `cyl_b25s75_rod_cap` | 2 | PA12-CF | pressure | (180, 0, 0) | 47 x 47 x 22 | 30 | 0.7 | yes |
| `cyl_b25s75_valve_saddle` | 2 | PETG | structural | (0, 0, 0) | 58 x 50 x 34 | 31 | 0.7 | yes |
| `cyl_b32s75_blind_cap` | 2 | PA12-CF | pressure | (0, 0, 0) | 54 x 54 x 57 | 53 | 1.3 | yes |
| `cyl_b32s75_piston` | 2 | PA12-CF | pressure | (0, 0, 0) | 32 x 32 x 14 | 10 | 0.2 | yes |
| `cyl_b32s75_rod_cap` | 2 | PA12-CF | pressure | (180, 0, 0) | 54 x 54 x 22 | 41 | 1.0 | yes |
| `cyl_b32s75_valve_saddle` | 2 | PETG | structural | (0, 0, 0) | 58 x 57 x 34 | 34 | 0.7 | yes |
| `hose_clip` | 40 | PETG | standard | (0, 0, 0) | 26 x 10 x 11 | 2 | 0.1 | yes |
| `encoder_bracket` | 14 | PETG | standard | (0, 0, 0) | 40 x 16 x 14 | 3 | 0.1 | yes |
| `encoder_magnet_cap` | 14 | PETG | standard | (0, 0, 0) | 21 x 21 x 9 | 3 | 0.1 | yes |
| `L_ankle_link` | 2 | PA12-CF | structural | (-90, 0, 0) | 171 x 236 x 152 | 138 | 3.3 | yes |
| `L_finger` | 2 | PETG | standard | (0, 90, 0) | 78 x 33 x 36 | 15 | 0.3 | yes |
| `L_foot` | 2 | PA12-CF | structural | (0, 0, 0) | 230 x 144 x 74 | 367 | 8.8 | yes |
| `L_forearm` | 2 | PETG | structural | (-90, 0, 0) | 64 x 239 x 98 | 125 | 2.6 | yes |
| `L_hand` | 2 | PETG | standard | (0, 90, 0) | 120 x 44 x 44 | 67 | 1.4 | yes |
| `L_hip_roll_link` | 2 | PA12-CF | structural | (0, 90, 0) | 165 x 182 x 206 | 125 | 3.0 | yes |
| `L_hip_yaw_link` | 2 | PA12-CF | structural | (180, 0, 0) | 123 x 130 x 200 | 109 | 2.6 | yes |
| `L_shin` | 2 | PA12-CF | structural | (-90, 0, 0) | 125 x 357 x 85 | 245 | 5.8 | yes |
| `L_shoulder_link` | 2 | PA12-CF | structural | (-90, 0, 0) | 83 x 71 x 145 | 96 | 2.3 | yes |
| `L_thigh` | 2 | PA12-CF | structural | (-90, 0, 0) | 171 x 338 x 91 | 235 | 5.6 | yes |
| `L_upper_arm` | 2 | PA12-CF | structural | (-90, 0, 0) | 114 x 212 x 95 | 140 | 3.4 | yes |
| `L_upper_arm_roll` | 2 | PETG | structural | (0, 0, 0) | 64 x 33 x 98 | 47 | 1.0 | yes |
| `foot_pad` | 2 | TPU95A | flexible | (0, 0, 0) | 230 x 125 x 3 | 100 | 2.2 | yes |
| `head` | 1 | PETG | standard | (0, 0, 0) | 140 x 130 x 200 | 386 | 8.1 | yes |
| `neck_link` | 1 | PETG | standard | (0, 0, 0) | 62 x 48 x 43 | 33 | 0.7 | yes |
| `pelvis` | 1 | PA12-CF | structural | (0, 0, 0) | 98 x 276 x 66 | 775 | 18.5 | yes |
| `torso` | 1 | PETG | standard | (0, 0, 0) | 190 x 378 x 384 | 1162 | 24.5 | yes |

**Total printed mass:** 8.33 kg  —  **estimated print time:** 190 h

Filament (+15 % waste): PA12-CF 5.50 kg, PETG 3.85 kg, TPU95A 0.23 kg

## Plates

- `cad/plates/PA12-CF_plate01.stl` — 13 parts: L_shin, R_shin, cyl_b16s140_blind_cap, cyl_b20s40_blind_cap, cyl_b20s40_rod_cap, cyl_b20s55_blind_cap, cyl_b20s55_rod_cap, cyl_b25s100_piston, pelvis
- `cad/plates/PA12-CF_plate02.stl` — 8 parts: L_thigh, R_thigh, cyl_b25s100_blind_cap, cyl_b32s75_blind_cap, cyl_b32s75_rod_cap, fit_coupon
- `cad/plates/PA12-CF_plate03.stl` — 6 parts: L_ankle_link, L_foot, L_hip_yaw_link, R_ankle_link, cyl_b16s140_blind_cap, cyl_b25s100_blind_cap
- `cad/plates/PA12-CF_plate04.stl` — 7 parts: L_hip_roll_link, L_upper_arm, R_hip_roll_link, R_hip_yaw_link, R_upper_arm, cyl_b25s100_rod_cap, cyl_b32s75_piston
- `cad/plates/PA12-CF_plate05.stl` — 26 parts: L_shoulder_link, R_foot, R_shoulder_link, cyl_b16s140_piston, cyl_b16s140_rod_cap, cyl_b20s40_piston, cyl_b20s55_piston, cyl_b25s100_piston, cyl_b25s100_rod_cap, cyl_b25s105_blind_cap, cyl_b25s105_piston, cyl_b25s105_rod_cap, cyl_b25s75_blind_cap, cyl_b25s75_piston, cyl_b25s75_rod_cap, cyl_b32s75_piston
- `cad/plates/PETG_plate01.stl` — 13 parts: L_forearm, R_forearm, cyl_b32s75_valve_saddle, encoder_bracket, hose_clip, torso
- `cad/plates/PETG_plate02.stl` — 22 parts: encoder_bracket, encoder_magnet_cap, hub_enclosure, hub_lid, limb_node_lid, torso_cover
- `cad/plates/PETG_plate03.stl` — 34 parts: L_hand, R_hand, cyl_b20s40_valve_saddle, cyl_b20s55_valve_saddle, cyl_b25s100_valve_saddle, cyl_b25s105_valve_saddle, cyl_b25s75_valve_saddle, cyl_b32s75_valve_saddle, encoder_bracket, head, hose_clip, limb_node_enclosure, limb_node_lid, neck_link
- `cad/plates/PETG_plate04.stl` — 36 parts: L_finger, L_upper_arm_roll, R_finger, R_upper_arm_roll, cyl_b16s140_valve_saddle, cyl_b20s40_valve_saddle, encoder_bracket, hose_clip
- `cad/plates/TPU95A_plate01.stl` — 2 parts: foot_pad

## Rules

1. Print `fit_coupon` first in every material; record results in `qa/build_log.yaml`.
2. Pressure parts (`*_cap`, `*_piston`): 100 % infill, 8 perimeters, 0.16 mm layers, dry filament.
3. Fibre-filled filaments need a hardened nozzle (see printer.nozzle_note in robot.yaml).
4. Bed max is 85 C: PA12-CF on textured PEI + glue stick at 80 C, enclosure recommended.
5. Install heat-set inserts at 245 C (PA-CF) / 220 C (PETG) before assembly.
