jitendraphand/robot-hydraulic/(commit log)

2026-11-11 HX-1: end-to-end 3D-printable hydraulic humanoid with recursive QA
    Single source of truth (config/robot.yaml) drives every artefact:
    - Hydraulics: tie-rod cylinder + linkage synthesis per joint against
    simulated torque demand (differential evolution, 7 joint types,
    smallest feasible bore), HPU pump/accumulator flow check.
    - CAD: parametric manifold3d parts (54 designs, 66 STLs, 10 bed plates)
    sized for the Elegoo Neptune 4 Max, print plan, BOM with cut list,
    exact-boolean assembly interference over 116 poses.
    - Simulation: MuJoCo model with CAD mass properties, ZMP preview-control
    walking, squat, single-leg balance and payload arm lift; recursive
    design loop (masses -> sim -> si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
    [L_ankle_link.stl, L_finger.stl, L_foot.stl, L_forearm.stl, L_hand.stl, L_hip_roll_link.stl, L_hip_yaw_link.stl, L_shin.stl]
2026-11-11 Add simulation videos of every task + balance stabilizer
    Videos (docs/video): walk, squat, single-leg balance, arm lift with
    1 kg payloads, stand, plus a montage and GIF previews for the README.
    Each clip is the same MuJoCo physics run the QA evaluates, rendered
    with the real CAD links as visual meshes; cylinders are drawn every
    frame between their live pin locations and a HUD shows each leg
    cylinder's load as a fraction of its hydraulic capacity at the current
    angle. `make videos` / `python -m hx video` (headless EGL + ffmpeg).
    Rendering the walk exposed a marginal open-loop gait: with the final
    CAD masses it developed a growing lateral rocking mode and fell at
    7.6 s, while the QA had vali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
    [L_ankle_link.stl, L_foot.stl, L_forearm.stl, L_hip_roll_link.stl, L_hip_yaw_link.stl, L_shin.stl, L_thigh.stl, L_upper_arm.stl]
